zephray/Fobu/hardware/pcb/pcb.kicad_pcb

## KiCad design hardware/pcb/pcb.kicad_pcb (2021-03-08)

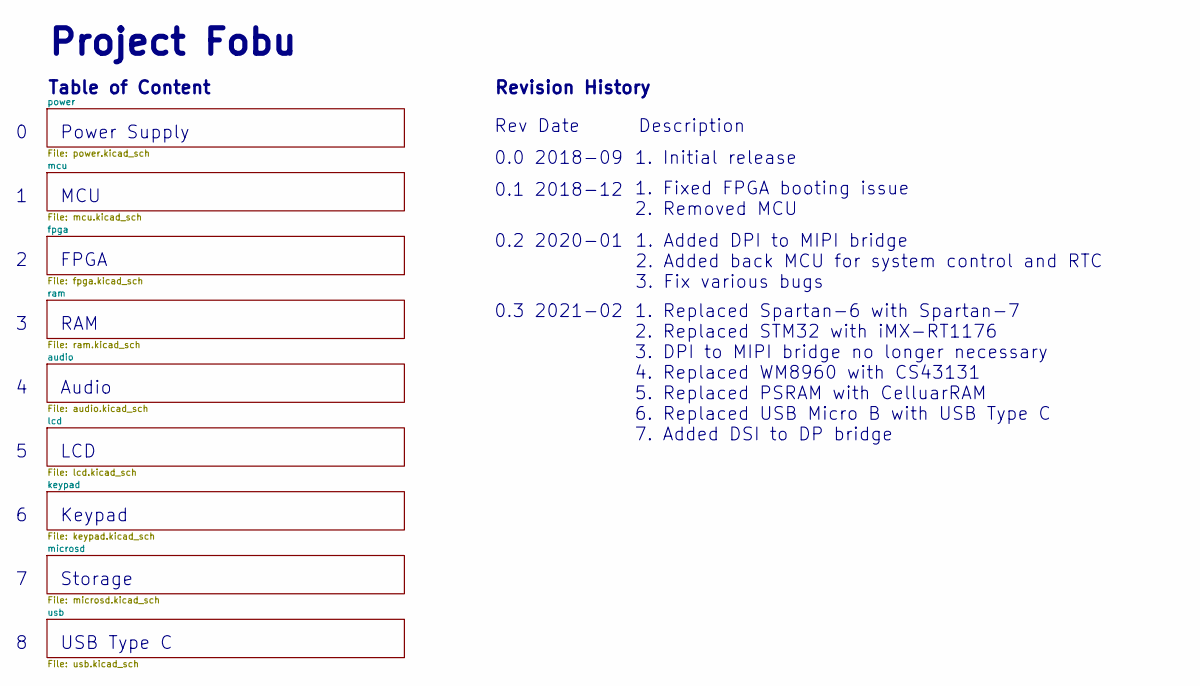
[picture p3: schematic pcb.kicad_sch, Fobu]

Notes on the sheet:
Project Fobu
Table of Content
Power Supply
MCU
FPGA
RAM
Audio
LCD
Keypad
Storage
USB Type C
Revision History
Rev Date Description
0.0 2018-09
0.1 2018-12
0.2 2020-01
0.3 2021-02
1. Initial release
1. Fixed FPGA booting issue 2. Removed MCU
1. Replaced Spartan-6 with Spartan-7 2. Replaced STM32 with iMX-RT1176 3. DPI to MIPI bridge no longer necessary 4. Replaced WM8960 with CS43131 5. Replaced PSRAM with CelluarRAM 6. Replaced USB Micro B with USB Type C 7. Added DSI to DP bridge
1. Added DPI to MIPI bridge 2. Added back MCU for system control and RTC 3. Fix various bugs

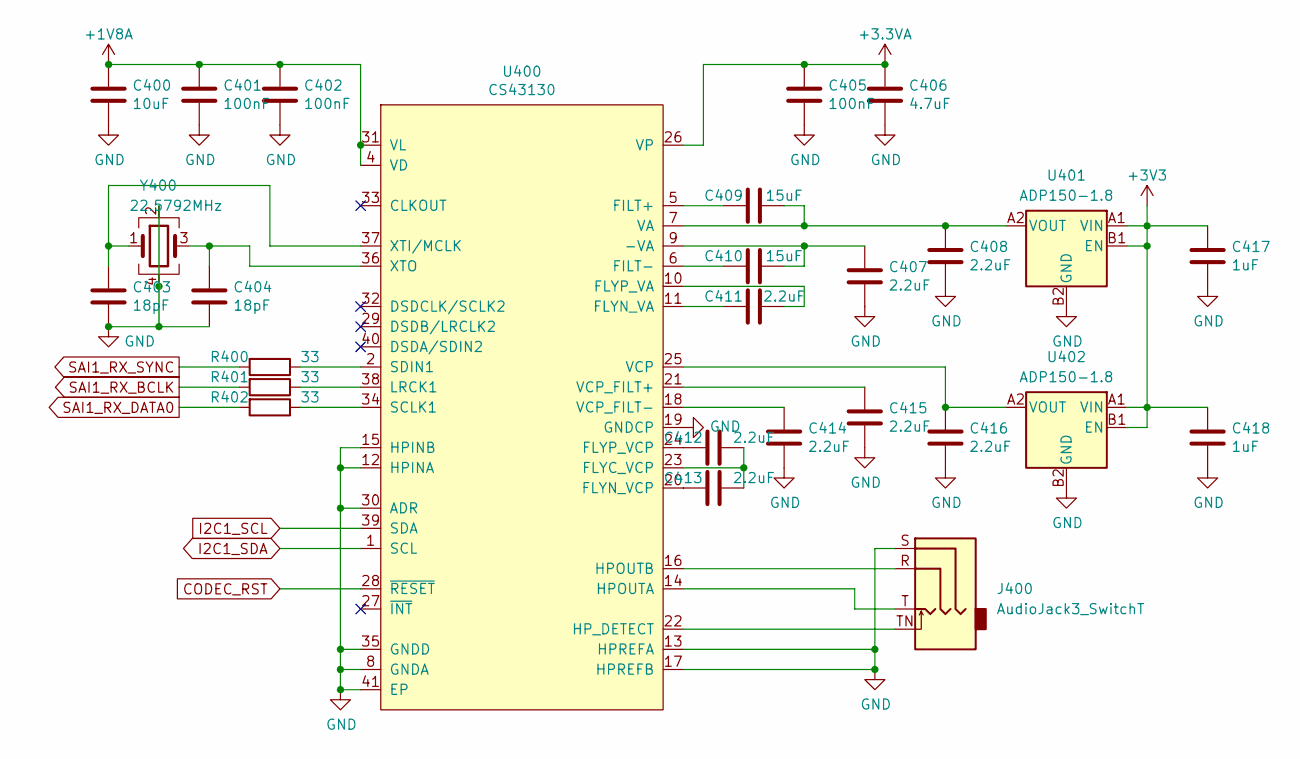
[picture p4: schematic audio.kicad_sch, Fobu]

Parts:
C400: 10uF; C_0402_1005Metric
C401, C402, C405: 100nF; C_0201_0603Metric
C403, C404: 18pF; C_0201_0603Metric
C406: 4.7uF; C_0402_1005Metric
C407, C408, C411, C412, C413, C414, C415, C416: 2.2uF; C_0402_1005Metric
C409, C410: 15uF; C_0603_1608Metric
C417, C418: 1uF; C_0402_1005Metric
J400: AudioJack3_SwitchT; PJ-327E
R400, R401, R402: 33; R_0402_1005Metric
U400: CS43130; QFN-40-1EP_5x5mm_P0.4mm_EP3.6x3.6mm_ThermalVias
U401, U402: ADP150-1.8; CSP-4_2x2_0.8x0.8mm
Y400: 22.5792MHz; Oscillator_SMD_Abracon_ASE-4Pin_3.2x2.5mm

Connections:
+1V8A: C400.1, C401.1, C402.1, U400.4 (VD), U400.31 (VL); also elsewhere on the board
+3.3VA: C405.1, C406.1, U400.26 (VP); also elsewhere on the board
+3V3: C417.1, C418.1, U401.A1 (VIN), U401.B1 (EN), U402.A1 (VIN), U402.B1 (EN); also elsewhere on the board
CODEC_RST: U400.28 (~RESET)
GND: C400.2, C401.2, C402.2, C403.2, C404.2, C405.2, C406.2, C407.2, C408.2, C414.2, C415.2, C416.2, C417.2, C418.2, J400.S, U400.8 (GNDA), U400.12 (HPINA), U400.13 (HPREFA), U400.15 (HPINB), U400.17 (HPREFB), U400.19 (GNDCP), U400.30 (ADR), U400.35 (GNDD), U400.41 (EP), U401.B2 (GND), U402.B2 (GND), Y400.2, Y400.4; also elsewhere on the board
I2C1_SCL: U400.39 (SDA); also elsewhere on the board
I2C1_SDA: U400.1 (SCL); also elsewhere on the board
unnamed: C403.1, U400.37 (XTI/MCLK), Y400.1
unnamed: C404.1, U400.36 (XTO), Y400.3
unnamed: C407.1, C410.1, U400.9 (-VA)
unnamed: C408.1, C409.1, U400.7 (VA), U401.A2 (VOUT)
unnamed: C409.2, U400.5 (FILT+)
unnamed: C410.2, U400.6 (FILT-)
unnamed: C411.1, U400.10 (FLYP_VA)
unnamed: C411.2, U400.11 (FLYN_VA)
unnamed: C412.1, C413.1, U400.23 (FLYC_VCP)
unnamed: C412.2, U400.24 (FLYP_VCP)
unnamed: C413.2, U400.20 (FLYN_VCP)
unnamed: C414.1, U400.18 (VCP_FILT-)
unnamed: C415.1, U400.21 (VCP_FILT+)
unnamed: C416.1, U400.25 (VCP), U402.A2 (VOUT)
unnamed: J400.R, U400.16 (HPOUTB)
unnamed: J400.T, U400.14 (HPOUTA)
unnamed: J400.TN, U400.22 (HP_DETECT)
unnamed: R400.1, U400.2 (SDIN1)
unnamed: R401.1, U400.38 (LRCK1)
unnamed: R402.1, U400.34 (SCLK1)
SAI1_RX_BCLK: R401.2; also elsewhere on the board
SAI1_RX_DATA0: R402.2; also elsewhere on the board
SAI1_RX_SYNC: R400.2; also elsewhere on the board

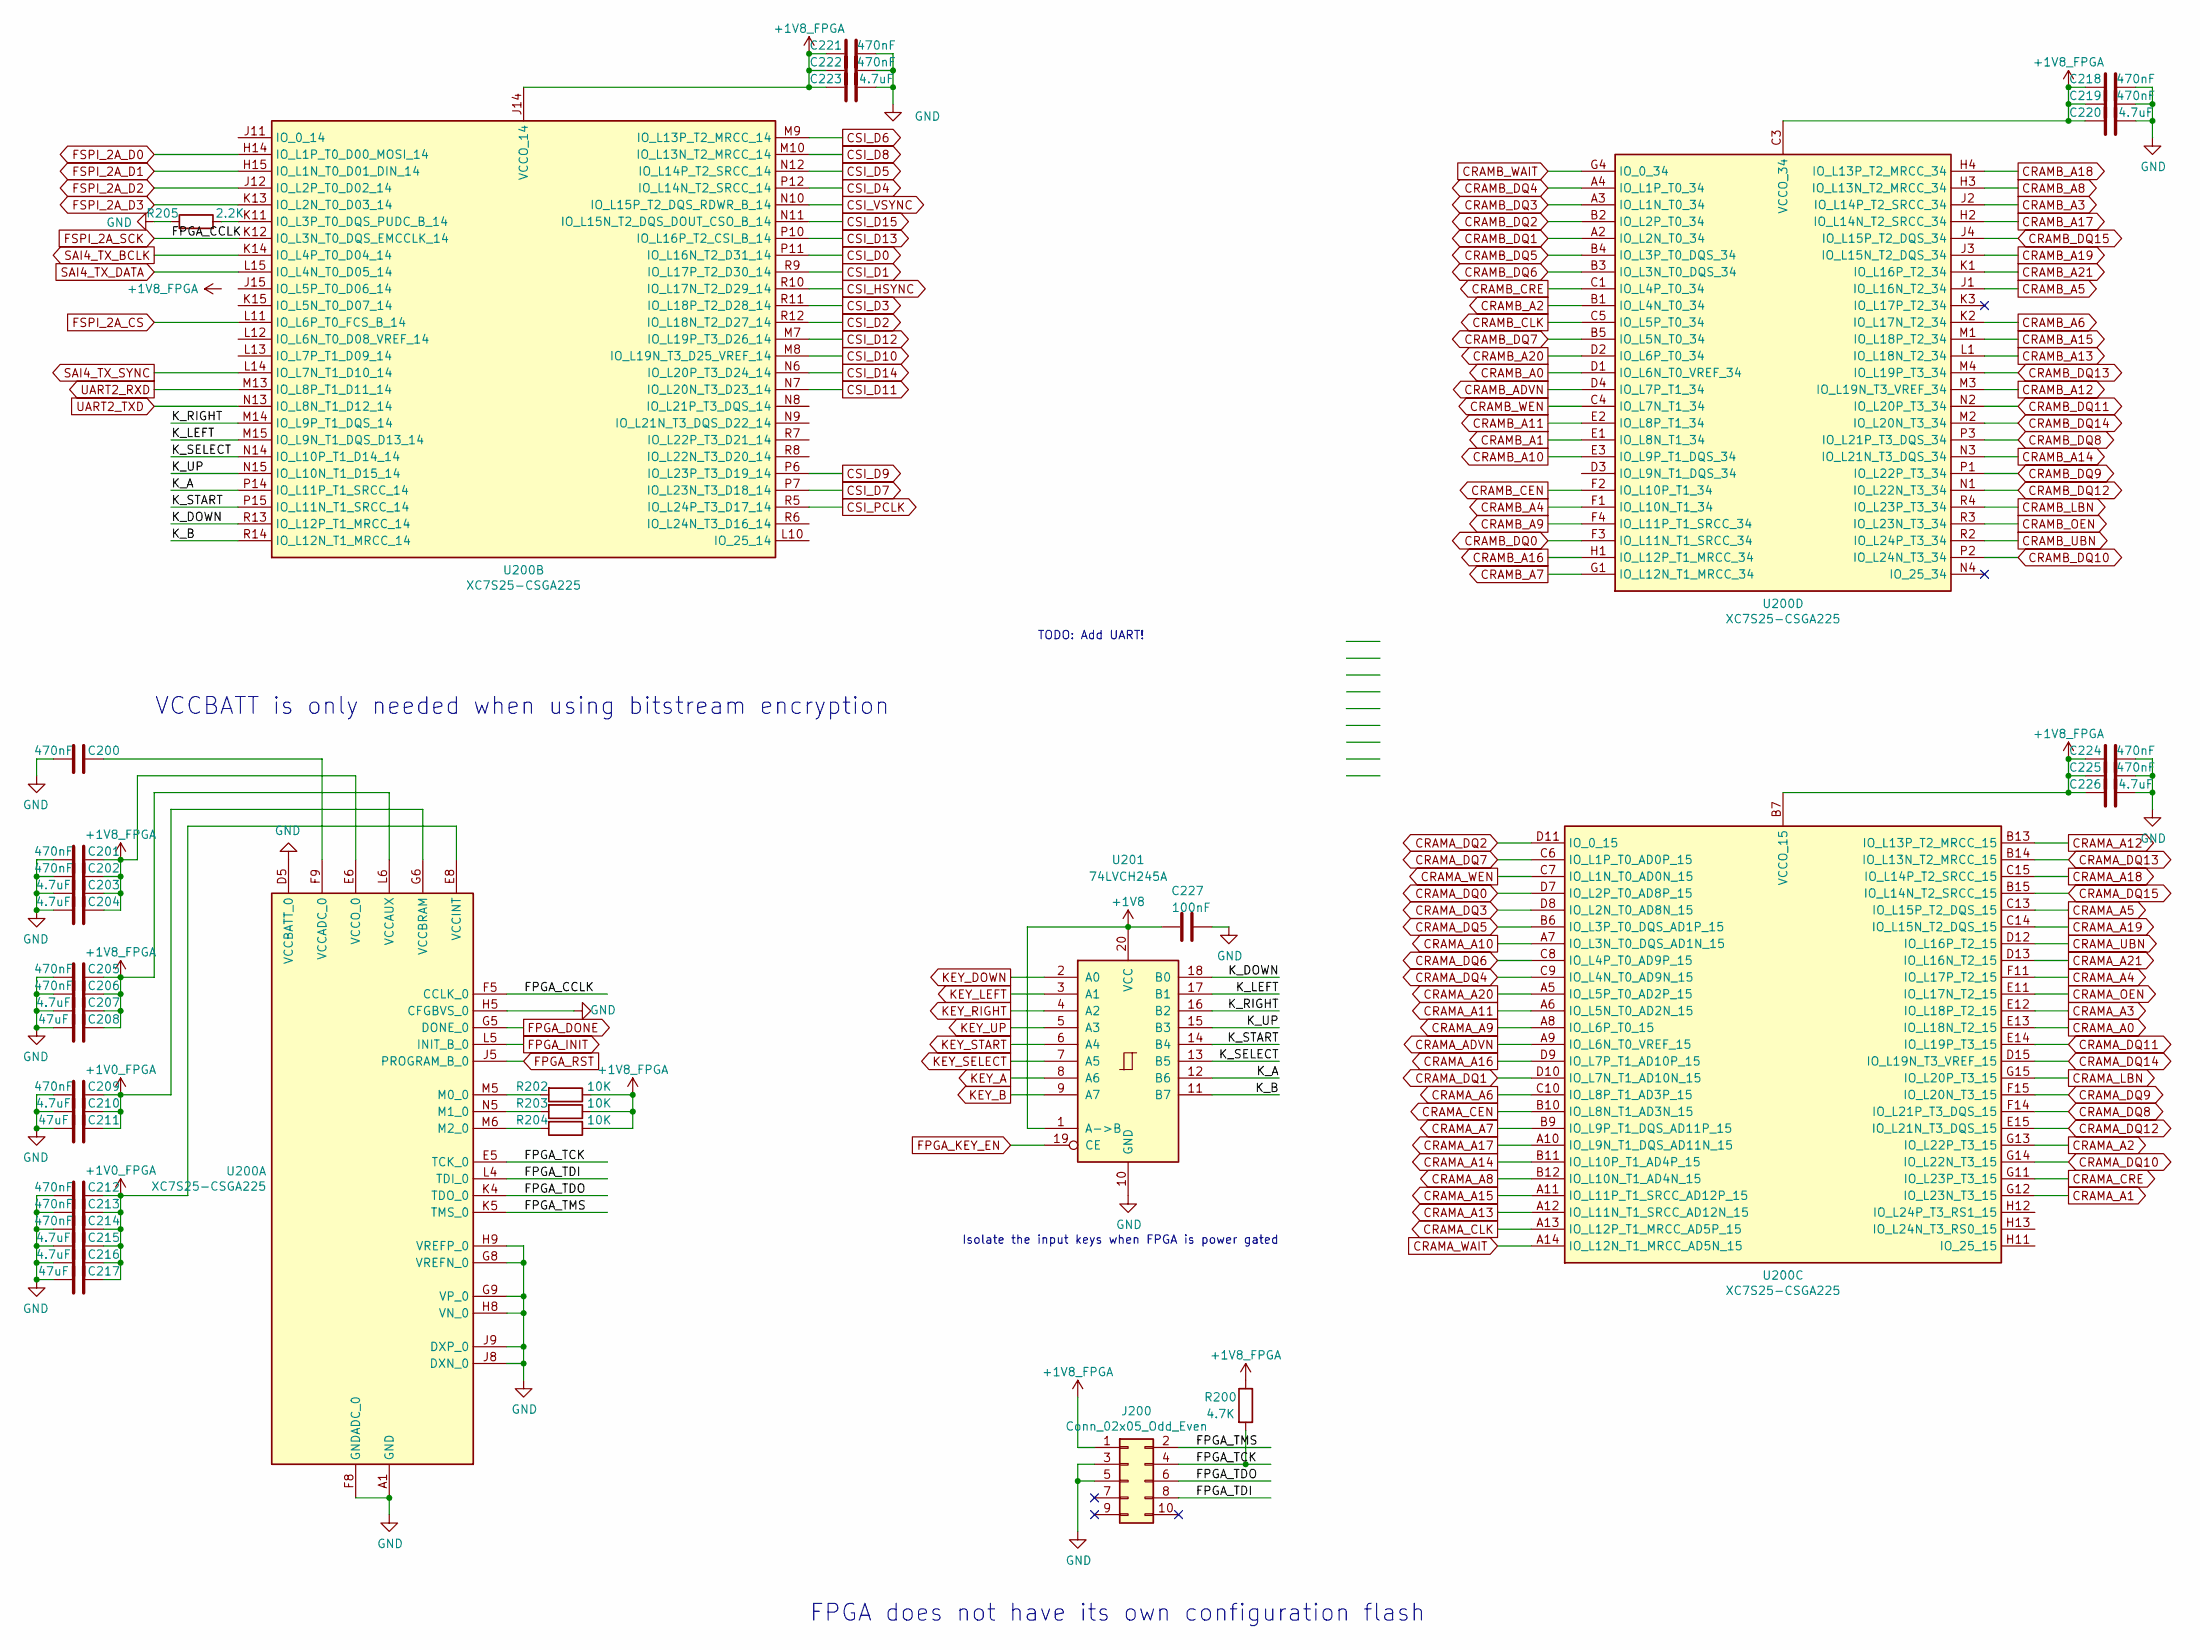
[picture p5: schematic fpga.kicad_sch, Fobu]

Parts:
C200, C201, C202, C205, C206, C209, C212, C213, C214, C218, C219, C221, C222, C224, C225: 470nF; C_0201_0603Metric
C203, C204, C207, C210, C215, C216, C220, C223, C226: 4.7uF; C_0402_1005Metric
C208, C211, C217: 47uF; C_0603_1608Metric
C227: 100nF; C_0201_0603Metric
J200: Conn_02x05_Odd_Even; PinHeader_2x05_P1.27mm_Vertical_SMD
R200: 4.7K; R_0402_1005Metric
R202, R203, R204: 10K; R_0402_1005Metric
R205: 2.2K; R_0402_1005Metric
U200: XC7S25-CSGA225; Xilinx_CSGA225
U201: 74LVCH245A; DHVQFN-20_EP_4.5x2.5_Pitch0.5mm

Connections:
+1V0_FPGA: C209.2, C210.2, C211.2, C212.2, C213.2, C214.2, C215.2, C216.2, C217.2, U200.E8 (VCCINT), U200.E10 (VCCINT), U200.F7 (VCCINT), U200.G6 (VCCBRAM), U200.G10 (VCCINT), U200.H7 (VCCINT), U200.J6 (VCCBRAM), U200.J10 (VCCINT), U200.K7 (VCCINT), U200.K9 (VCCINT); also elsewhere on the board
+1V8: C227.1, U201.1 (A->B), U201.20 (VCC); also elsewhere on the board
/fpga/FPGA_TCK: J200.4, R200.2, U200.E5 (TCK_0)
/fpga/FPGA_TDI: J200.8, U200.L4 (TDI_0)
/fpga/FPGA_TDO: J200.6, U200.K4 (TDO_0)
/fpga/FPGA_TMS: J200.2, U200.K5 (TMS_0)
/fpga/K_A: U200.P14 (IO_L11P_T1_SRCC_14), U201.12 (B6)
/fpga/K_B: U200.R14 (IO_L12N_T1_MRCC_14), U201.11 (B7)
/fpga/K_DOWN: U200.R13 (IO_L12P_T1_MRCC_14), U201.18 (B0)
/fpga/K_LEFT: U200.M15 (IO_L9N_T1_DQS_D13_14), U201.17 (B1)
/fpga/K_RIGHT: U200.M14 (IO_L9P_T1_DQS_14), U201.16 (B2)
/fpga/K_SELECT: U200.N14 (IO_L10P_T1_D14_14), U201.13 (B5)
/fpga/K_START: U200.P15 (IO_L11N_T1_SRCC_14), U201.14 (B4)
/fpga/K_UP: U200.N15 (IO_L10N_T1_D15_14), U201.15 (B3)
CRAMA_A0: U200.E13 (IO_L18N_T2_15); also elsewhere on the board
CRAMA_A1: U200.G12 (IO_L23N_T3_15); also elsewhere on the board
CRAMA_A2: U200.G13 (IO_L22P_T3_15); also elsewhere on the board
CRAMA_A3: U200.E12 (IO_L18P_T2_15); also elsewhere on the board
CRAMA_A4: U200.F11 (IO_L17P_T2_15); also elsewhere on the board
CRAMA_A5: U200.C13 (IO_L15P_T2_DQS_15); also elsewhere on the board
CRAMA_A6: U200.C10 (IO_L8P_T1_AD3P_15); also elsewhere on the board
CRAMA_A7: U200.B9 (IO_L9P_T1_DQS_AD11P_15); also elsewhere on the board
CRAMA_A8: U200.B12 (IO_L10N_T1_AD4N_15); also elsewhere on the board
CRAMA_A9: U200.A8 (IO_L6P_T0_15); also elsewhere on the board
CRAMA_A10: U200.A7 (IO_L3N_T0_DQS_AD1N_15); also elsewhere on the board
CRAMA_A11: U200.A6 (IO_L5N_T0_AD2N_15); also elsewhere on the board
CRAMA_A12: U200.B13 (IO_L13P_T2_MRCC_15); also elsewhere on the board
CRAMA_A13: U200.A12 (IO_L11N_T1_SRCC_AD12N_15); also elsewhere on the board
CRAMA_A14: U200.B11 (IO_L10P_T1_AD4P_15); also elsewhere on the board
CRAMA_A15: U200.A11 (IO_L11P_T1_SRCC_AD12P_15); also elsewhere on the board
CRAMA_A16: U200.D9 (IO_L7P_T1_AD10P_15); also elsewhere on the board
CRAMA_A17: U200.A10 (IO_L9N_T1_DQS_AD11N_15); also elsewhere on the board
CRAMA_A18: U200.C15 (IO_L14P_T2_SRCC_15); also elsewhere on the board
CRAMA_A19: U200.C14 (IO_L15N_T2_DQS_15); also elsewhere on the board
CRAMA_A20: U200.A5 (IO_L5P_T0_AD2P_15); also elsewhere on the board
CRAMA_A21: U200.D13 (IO_L16N_T2_15); also elsewhere on the board
CRAMA_ADVN: U200.A9 (IO_L6N_T0_VREF_15); also elsewhere on the board
CRAMA_CEN: U200.B10 (IO_L8N_T1_AD3N_15); also elsewhere on the board
CRAMA_CLK: U200.A13 (IO_L12P_T1_MRCC_AD5P_15); also elsewhere on the board
CRAMA_CRE: U200.G11 (IO_L23P_T3_15); also elsewhere on the board
CRAMA_DQ0: U200.D7 (IO_L2P_T0_AD8P_15); also elsewhere on the board
CRAMA_DQ1: U200.D10 (IO_L7N_T1_AD10N_15); also elsewhere on the board
CRAMA_DQ2: U200.D11 (IO_0_15); also elsewhere on the board
CRAMA_DQ3: U200.D8 (IO_L2N_T0_AD8N_15); also elsewhere on the board
CRAMA_DQ4: U200.C9 (IO_L4N_T0_AD9N_15); also elsewhere on the board
CRAMA_DQ5: U200.B6 (IO_L3P_T0_DQS_AD1P_15); also elsewhere on the board
CRAMA_DQ6: U200.C8 (IO_L4P_T0_AD9P_15); also elsewhere on the board
CRAMA_DQ7: U200.C6 (IO_L1P_T0_AD0P_15); also elsewhere on the board
CRAMA_DQ8: U200.F14 (IO_L21P_T3_DQS_15); also elsewhere on the board
CRAMA_DQ9: U200.F15 (IO_L20N_T3_15); also elsewhere on the board
CRAMA_DQ10: U200.G14 (IO_L22N_T3_15); also elsewhere on the board
CRAMA_DQ11: U200.E14 (IO_L19P_T3_15); also elsewhere on the board
CRAMA_DQ12: U200.E15 (IO_L21N_T3_DQS_15); also elsewhere on the board
CRAMA_DQ13: U200.B14 (IO_L13N_T2_MRCC_15); also elsewhere on the board
CRAMA_DQ14: U200.D15 (IO_L19N_T3_VREF_15); also elsewhere on the board
CRAMA_DQ15: U200.B15 (IO_L14N_T2_SRCC_15); also elsewhere on the board
CRAMA_LBN: U200.G15 (IO_L20P_T3_15); also elsewhere on the board
CRAMA_OEN: U200.E11 (IO_L17N_T2_15); also elsewhere on the board
CRAMA_UBN: U200.D12 (IO_L16P_T2_15); also elsewhere on the board
CRAMA_WAIT: U200.A14 (IO_L12N_T1_MRCC_AD5N_15); also elsewhere on the board
CRAMA_WEN: U200.C7 (IO_L1N_T0_AD0N_15); also elsewhere on the board
CRAMB_A0: U200.D1 (IO_L6N_T0_VREF_34); also elsewhere on the board
CRAMB_A1: U200.E1 (IO_L8N_T1_34); also elsewhere on the board
CRAMB_A2: U200.B1 (IO_L4N_T0_34); also elsewhere on the board
CRAMB_A3: U200.J2 (IO_L14P_T2_SRCC_34); also elsewhere on the board
CRAMB_A4: U200.F1 (IO_L10N_T1_34); also elsewhere on the board
CRAMB_A5: U200.J1 (IO_L16N_T2_34); also elsewhere on the board
CRAMB_A6: U200.K2 (IO_L17N_T2_34); also elsewhere on the board
CRAMB_A7: U200.G1 (IO_L12N_T1_MRCC_34); also elsewhere on the board
CRAMB_A8: U200.H3 (IO_L13N_T2_MRCC_34); also elsewhere on the board
CRAMB_A9: U200.F4 (IO_L11P_T1_SRCC_34); also elsewhere on the board
CRAMB_A10: U200.E3 (IO_L9P_T1_DQS_34); also elsewhere on the board
CRAMB_A11: U200.E2 (IO_L8P_T1_34); also elsewhere on the board
CRAMB_A12: U200.M3 (IO_L19N_T3_VREF_34); also elsewhere on the board
CRAMB_A13: U200.L1 (IO_L18N_T2_34); also elsewhere on the board
CRAMB_A14: U200.N3 (IO_L21N_T3_DQS_34); also elsewhere on the board
CRAMB_A15: U200.M1 (IO_L18P_T2_34); also elsewhere on the board
CRAMB_A16: U200.H1 (IO_L12P_T1_MRCC_34); also elsewhere on the board
CRAMB_A17: U200.H2 (IO_L14N_T2_SRCC_34); also elsewhere on the board
CRAMB_A18: U200.H4 (IO_L13P_T2_MRCC_34); also elsewhere on the board
CRAMB_A19: U200.J3 (IO_L15N_T2_DQS_34); also elsewhere on the board
CRAMB_A20: U200.D2 (IO_L6P_T0_34); also elsewhere on the board
CRAMB_A21: U200.K1 (IO_L16P_T2_34); also elsewhere on the board
CRAMB_ADVN: U200.D4 (IO_L7P_T1_34); also elsewhere on the board
CRAMB_CEN: U200.F2 (IO_L10P_T1_34); also elsewhere on the board
CRAMB_CLK: U200.C5 (IO_L5P_T0_34); also elsewhere on the board
CRAMB_CRE: U200.C1 (IO_L4P_T0_34); also elsewhere on the board
CRAMB_DQ0: U200.F3 (IO_L11N_T1_SRCC_34); also elsewhere on the board
CRAMB_DQ1: U200.A2 (IO_L2N_T0_34); also elsewhere on the board
CRAMB_DQ2: U200.B2 (IO_L2P_T0_34); also elsewhere on the board
CRAMB_DQ3: U200.A3 (IO_L1N_T0_34); also elsewhere on the board
CRAMB_DQ4: U200.A4 (IO_L1P_T0_34); also elsewhere on the board
CRAMB_DQ5: U200.B4 (IO_L3P_T0_DQS_34); also elsewhere on the board
CRAMB_DQ6: U200.B3 (IO_L3N_T0_DQS_34); also elsewhere on the board
CRAMB_DQ7: U200.B5 (IO_L5N_T0_34); also elsewhere on the board
CRAMB_DQ8: U200.P3 (IO_L21P_T3_DQS_34); also elsewhere on the board
CRAMB_DQ9: U200.P1 (IO_L22P_T3_34); also elsewhere on the board
CRAMB_DQ10: U200.P2 (IO_L24N_T3_34); also elsewhere on the board
CRAMB_DQ11: U200.N2 (IO_L20P_T3_34); also elsewhere on the board
CRAMB_DQ12: U200.N1 (IO_L22N_T3_34); also elsewhere on the board
CRAMB_DQ13: U200.M4 (IO_L19P_T3_34); also elsewhere on the board
CRAMB_DQ14: U200.M2 (IO_L20N_T3_34); also elsewhere on the board
CRAMB_DQ15: U200.J4 (IO_L15P_T2_DQS_34); also elsewhere on the board
CRAMB_LBN: U200.R4 (IO_L23P_T3_34); also elsewhere on the board
CRAMB_OEN: U200.R3 (IO_L23N_T3_34); also elsewhere on the board
CRAMB_UBN: U200.R2 (IO_L24P_T3_34); also elsewhere on the board
CRAMB_WAIT: U200.G4 (IO_0_34); also elsewhere on the board
CRAMB_WEN: U200.C4 (IO_L7N_T1_34); also elsewhere on the board
CSI_D0: U200.P11 (IO_L16N_T2_D31_14); also elsewhere on the board
CSI_D1: U200.R9 (IO_L17P_T2_D30_14); also elsewhere on the board
CSI_D2: U200.R12 (IO_L18N_T2_D27_14); also elsewhere on the board
CSI_D3: U200.R11 (IO_L18P_T2_D28_14); also elsewhere on the board
CSI_D4: U200.P12 (IO_L14N_T2_SRCC_14); also elsewhere on the board
CSI_D5: U200.N12 (IO_L14P_T2_SRCC_14); also elsewhere on the board
CSI_D6: U200.M9 (IO_L13P_T2_MRCC_14); also elsewhere on the board
CSI_D7: U200.P7 (IO_L23N_T3_D18_14); also elsewhere on the board
CSI_D8: U200.M10 (IO_L13N_T2_MRCC_14); also elsewhere on the board
CSI_D9: U200.P6 (IO_L23P_T3_D19_14); also elsewhere on the board
CSI_D10: U200.M8 (IO_L19N_T3_D25_VREF_14); also elsewhere on the board
CSI_D11: U200.N7 (IO_L20N_T3_D23_14); also elsewhere on the board
CSI_D12: U200.M7 (IO_L19P_T3_D26_14); also elsewhere on the board
CSI_D13: U200.P10 (IO_L16P_T2_CSI_B_14); also elsewhere on the board
CSI_D14: U200.N6 (IO_L20P_T3_D24_14); also elsewhere on the board
CSI_D15: U200.N11 (IO_L15N_T2_DQS_DOUT_CSO_B_14); also elsewhere on the board
CSI_HSYNC: U200.R10 (IO_L17N_T2_D29_14); also elsewhere on the board
CSI_PCLK: U200.R5 (IO_L24P_T3_D17_14); also elsewhere on the board
CSI_VSYNC: U200.N10 (IO_L15P_T2_DQS_RDWR_B_14); also elsewhere on the board
FPGA_DONE: U200.G5 (DONE_0); also elsewhere on the board
FPGA_INIT: U200.L5 (INIT_B_0); also elsewhere on the board
FPGA_KEY_EN: U201.19 (CE); also elsewhere on the board
FPGA_RST: U200.J5 (PROGRAM_B_0); also elsewhere on the board
FSPI_2A_CS: U200.L11 (IO_L6P_T0_FCS_B_14); also elsewhere on the board
FSPI_2A_D0: U200.H14 (IO_L1P_T0_D00_MOSI_14); also elsewhere on the board
FSPI_2A_D1: U200.H15 (IO_L1N_T0_D01_DIN_14); also elsewhere on the board
FSPI_2A_D2: U200.J12 (IO_L2P_T0_D02_14); also elsewhere on the board
FSPI_2A_D3: U200.K13 (IO_L2N_T0_D03_14); also elsewhere on the board
FSPI_2A_SCK: U200.F5 (CCLK_0), U200.K12 (IO_L3N_T0_DQS_EMCCLK_14); also elsewhere on the board
GND: C200.1, C201.1, C202.1, C203.1, C204.1, C205.1, C206.1, C207.1, C208.1, C209.1, C210.1, C211.1, C212.1, C213.1, C214.1, C215.1, C216.1, C217.1, C218.1, C219.1, C220.1, C221.1, C222.1, C223.1, C224.1, C225.1, C226.1, C227.2, J200.3, J200.5, R205.1, U200.A1 (GND), U200.A15 (GND), U200.B8 (GND), U200.C2 (GND), U200.C12 (GND), U200.D5 (VCCBATT_0), U200.D6 (GND), U200.D14 (GND), U200.E4 (GND), U200.E7 (GND), U200.E9 (GND), U200.F6 (GND), U200.F8 (GNDADC_0), U200.F10 (GND), U200.F13 (GND), U200.G3 (GND), U200.G7 (GND), U200.G8 (VREFN_0), U200.G9 (VP_0), U200.H5 (CFGBVS_0), U200.H6 (GND), U200.H8 (VN_0), U200.H9 (VREFP_0), U200.H10 (GND), U200.J7 (GND), U200.J8 (DXN_0), U200.J9 (DXP_0), U200.J13 (GND), U200.K6 (GND), U200.K8 (GND), U200.K10 (GND), U200.L2 (GND), U200.L7 (GND), U200.L9 (GND), U200.M11 (GND), U200.P4 (GND), U200.P8 (GND), U200.P13 (GND), U200.R1 (GND), U200.R15 (GND), U201.10 (GND); also elsewhere on the board
KEY_A: U201.8 (A6); also elsewhere on the board
KEY_B: U201.9 (A7); also elsewhere on the board
KEY_DOWN: U201.2 (A0); also elsewhere on the board
KEY_LEFT: U201.3 (A1); also elsewhere on the board
KEY_RIGHT: U201.4 (A2); also elsewhere on the board
KEY_SELECT: U201.7 (A5); also elsewhere on the board
KEY_START: U201.6 (A4); also elsewhere on the board
KEY_UP: U201.5 (A3); also elsewhere on the board
unnamed: R202.2, U200.M5 (M0_0)
unnamed: R203.2, U200.N5 (M1_0)
unnamed: R204.2, U200.M6 (M2_0)
unnamed: R205.2, U200.K11 (IO_L3P_T0_DQS_PUDC_B_14)
SAI4_TX_BCLK: U200.K14 (IO_L4P_T0_D04_14); also elsewhere on the board
SAI4_TX_DATA: U200.L15 (IO_L4N_T0_D05_14); also elsewhere on the board
SAI4_TX_SYNC: U200.L14 (IO_L7N_T1_D10_14); also elsewhere on the board
UART2_RXD: U200.M13 (IO_L8P_T1_D11_14); also elsewhere on the board
UART2_TXD: U200.N13 (IO_L8N_T1_D12_14); also elsewhere on the board

Notes on the sheet:
VCCBATT is only needed when using bitstream encryption
FPGA does not have its own configuration flash
TODO: Add UART!
Isolate the input keys when FPGA is power gated

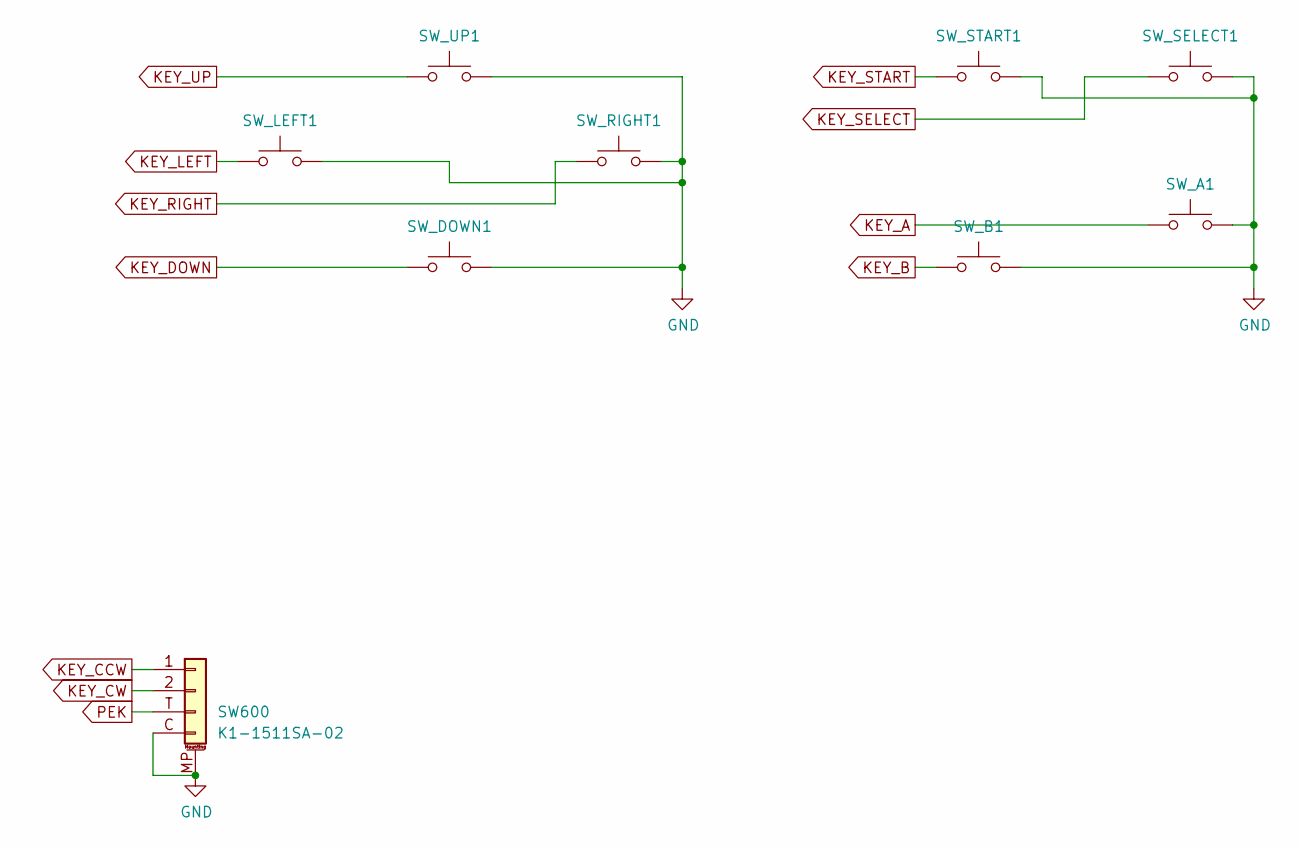
[picture p6: schematic keypad.kicad_sch, Fobu]

Parts:
SW600: K1-1511SA-02
SW_A1: SW_Push; SW_SPST_K21177SR
SW_B1: SW_Push; SW_SPST_K21177SR
SW_DOWN1: SW_Push; SW_SPST_K21177SR
SW_LEFT1: SW_Push; SW_SPST_K21177SR
SW_RIGHT1: SW_Push; SW_SPST_K21177SR
SW_SELECT1: SW_Push; SW_SPST_K21177SR
SW_START1: SW_Push; SW_SPST_K21177SR
SW_UP1: SW_Push; SW_SPST_K21177SR

Connections:
GND: SW600.C (Pin_4), SW600.MP (MountPin), SW_A1.2, SW_B1.2, SW_DOWN1.2, SW_LEFT1.2, SW_RIGHT1.2, SW_SELECT1.2, SW_START1.2, SW_UP1.2; also elsewhere on the board
KEY_A: SW_A1.1; also elsewhere on the board
KEY_B: SW_B1.1; also elsewhere on the board
KEY_CCW: SW600.1
KEY_CW: SW600.2
KEY_DOWN: SW_DOWN1.1; also elsewhere on the board
KEY_LEFT: SW_LEFT1.1; also elsewhere on the board
KEY_RIGHT: SW_RIGHT1.1; also elsewhere on the board
KEY_SELECT: SW_SELECT1.1; also elsewhere on the board
KEY_START: SW_START1.1; also elsewhere on the board
KEY_UP: SW_UP1.1; also elsewhere on the board
PEK: SW600.T (Pin_3); also elsewhere on the board

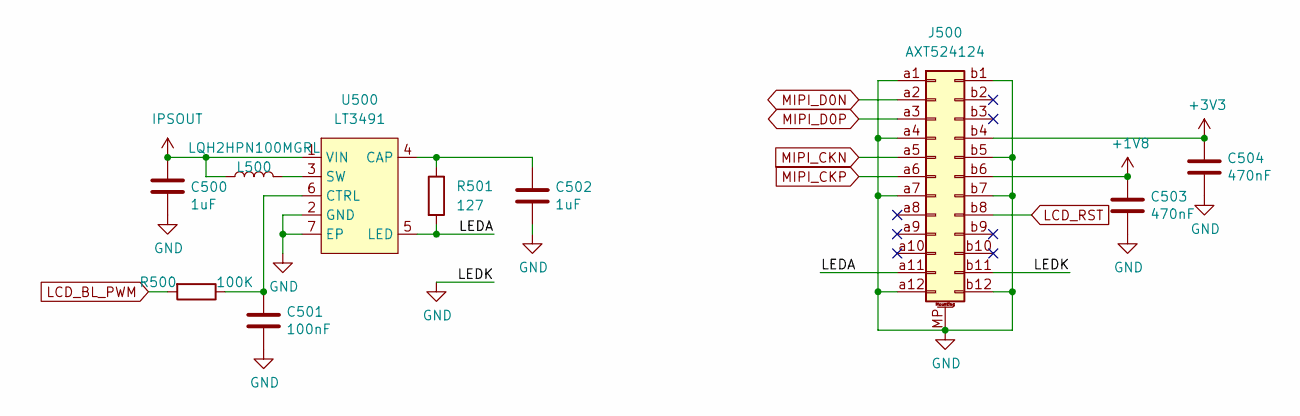
[picture p7: schematic lcd.kicad_sch, Fobu]

Parts:
C500, C502: 1uF; C_0402_1005Metric
C501: 100nF; C_0201_0603Metric
C503, C504: 470nF; C_0201_0603Metric
J500: AXT524124
L500: LQH2HPN100MGRL; L_1008_2520Metric
R500: 100K; R_0402_1005Metric
R501: 127; R_0402_1005Metric
U500: LT3491; DFN-6-1EP_2x2mm_P0.5mm_EP0.61x1.42mm

Connections:
+1V8: C503.1, J500.b6; also elsewhere on the board
+3V3: C504.1, J500.b4; also elsewhere on the board
/lcd/LEDA: J500.a11, R501.2, U500.5 (LED)
GND: C500.2, C501.2, C502.2, C503.2, C504.2, J500.MP (MountPin), J500.a1, J500.a4, J500.a7, J500.a12, J500.b1, J500.b5, J500.b7, J500.b11, J500.b12, U500.2 (GND), U500.7 (EP); also elsewhere on the board
IPSOUT: C500.1, L500.1, U500.1 (VIN); also elsewhere on the board
LCD_BL_PWM: R500.2
LCD_RST: J500.b8
MIPI_CKN: J500.a5; also elsewhere on the board
MIPI_CKP: J500.a6; also elsewhere on the board
MIPI_D0N: J500.a2; also elsewhere on the board
MIPI_D0P: J500.a3; also elsewhere on the board
unnamed: C501.1, R500.1, U500.6 (CTRL)
unnamed: C502.1, R501.1, U500.4 (CAP)
unnamed: L500.2, U500.3 (SW)
