zephray/Fobu/hardware/pcb/pcb.kicad_pcb

## KiCad design hardware/pcb/pcb.kicad_pcb (continued)

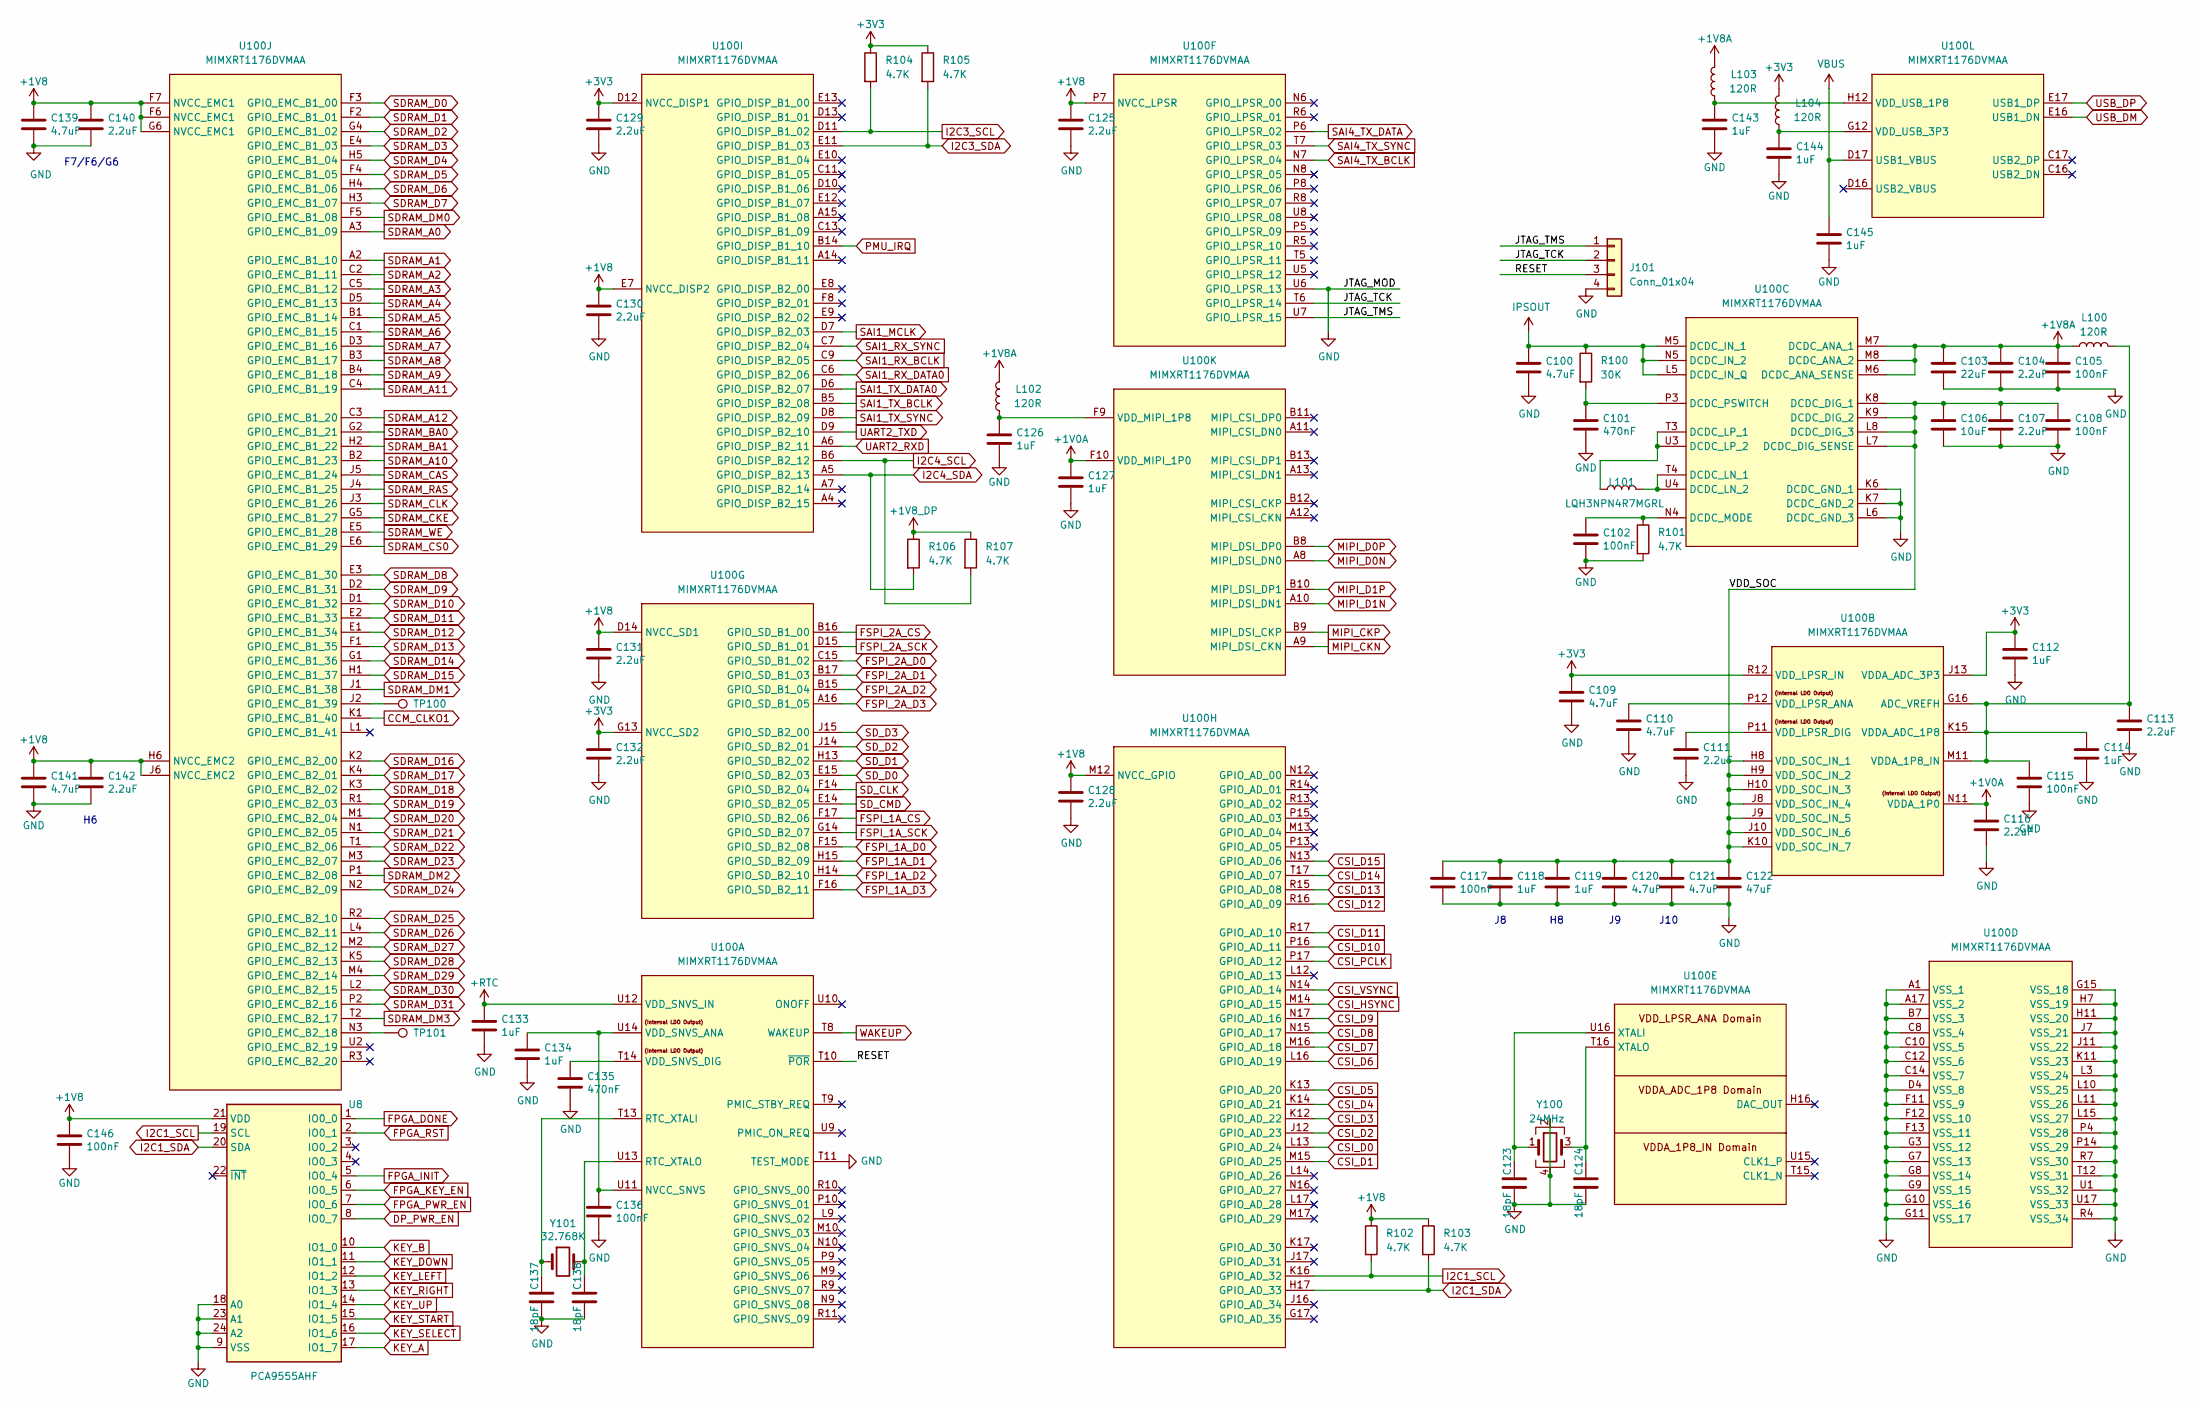
[picture p8: schematic mcu.kicad_sch, Fobu]

Parts:
C100, C109, C110, C120, C121, C139, C141: 4.7uF; C_0402_1005Metric
C101, C135: 470nF; C_0201_0603Metric
C102, C105, C108, C115, C117, C136, C146: 100nF; C_0201_0603Metric
C103: 22uF; C_0603_1608Metric
C104, C107, C111, C113, C116, C125, C128, C129, C130, C131, C132, C140, C142: 2.2uF; C_0402_1005Metric
C106: 10uF; C_0402_1005Metric
C112, C114, C118, C119, C126, C127, C133, C134, C143, C144, C145: 1uF; C_0402_1005Metric
C122: 47uF; C_0603_1608Metric
C123, C124, C137, C138: 18pF; C_0201_0603Metric
J101: Conn_01x04; PinHeader_1x04_P1.27mm_Vertical_SMD_Pin1Left
L100, L102, L103, L104: 120R; L_0402_1005Metric
L101: LQH3NPN4R7MGRL; L_Vishay_IHLP-1212
R100: 30K; R_0402_1005Metric
R101, R102, R103, R104, R105, R106, R107: 4.7K; R_0402_1005Metric
TP100, TP101: TestPoint; TestPoint_Pad_D0.5mm
U8: PCA9555AHF; HVQFN-24-1EP_4x4mm_P0.5mm_EP2.5x2.5mm
U100: MIMXRT1176DVMAA; BGA-289_17x17_14.0x14.0mm
Y100: 24MHz; Oscillator_SMD_Abracon_ASE-4Pin_3.2x2.5mm
Y101: 32.768K; Crystal_SMD_TXC_9HT11-2Pin_2.0x1.2mm_HandSoldering

Connections:
+1V0A: C116.1, C127.1, U100.F10 (VDD_MIPI_1P0), U100.N11 (VDDA_1P0)
+1V8: C125.1, C128.1, C130.1, C131.1, C139.1, C140.1, C141.1, C142.1, C146.1, R102.1, R103.1, U8.21 (VDD), U100.D14 (NVCC_SD1), U100.E7 (NVCC_DISP2), U100.F6 (NVCC_EMC1), U100.F7 (NVCC_EMC1), U100.G6 (NVCC_EMC1), U100.H6 (NVCC_EMC2), U100.J6 (NVCC_EMC2), U100.M12 (NVCC_GPIO), U100.P7 (NVCC_LPSR); also elsewhere on the board
+1V8A: C103.1, C104.1, C105.1, L100.1, L102.2, L103.2, U100.M6 (DCDC_ANA_SENSE), U100.M7 (DCDC_ANA_1), U100.M8 (DCDC_ANA_2); also elsewhere on the board
+1V8_DP: R106.1, R107.1; also elsewhere on the board
+3V3: C109.1, C112.1, C129.1, C132.1, L104.2, R104.1, R105.1, U100.D12 (NVCC_DISP1), U100.G13 (NVCC_SD2), U100.J13 (VDDA_ADC_3P3), U100.R12 (VDD_LPSR_IN); also elsewhere on the board
+RTC: C133.1, U100.U12 (VDD_SNVS_IN); also elsewhere on the board
/mcu/JTAG_TCK: J101.2, U100.T6 (GPIO_LPSR_14)
/mcu/JTAG_TMS: J101.1, U100.U7 (GPIO_LPSR_15)
/mcu/RESET: J101.3, U100.T10 (~POR)
/mcu/VDD_SOC: C106.1, C107.1, C108.1, C117.1, C118.1, C119.1, C120.1, C121.1, C122.1, U100.H8 (VDD_SOC_IN_1), U100.H9 (VDD_SOC_IN_2), U100.H10 (VDD_SOC_IN_3), U100.J8 (VDD_SOC_IN_4), U100.J9 (VDD_SOC_IN_5), U100.J10 (VDD_SOC_IN_6), U100.K8 (DCDC_DIG_1), U100.K9 (DCDC_DIG_2), U100.K10 (VDD_SOC_IN_7), U100.L7 (DCDC_DIG_SENSE), U100.L8 (DCDC_DIG_3)
CCM_CLKO1: U100.K1 (GPIO_EMC_B1_40)
CSI_D0: U100.L13 (GPIO_AD_24); also elsewhere on the board
CSI_D1: U100.M15 (GPIO_AD_25); also elsewhere on the board
CSI_D2: U100.J12 (GPIO_AD_23); also elsewhere on the board
CSI_D3: U100.K12 (GPIO_AD_22); also elsewhere on the board
CSI_D4: U100.K14 (GPIO_AD_21); also elsewhere on the board
CSI_D5: U100.K13 (GPIO_AD_20); also elsewhere on the board
CSI_D6: U100.L16 (GPIO_AD_19); also elsewhere on the board
CSI_D7: U100.M16 (GPIO_AD_18); also elsewhere on the board
CSI_D8: U100.N15 (GPIO_AD_17); also elsewhere on the board
CSI_D9: U100.N17 (GPIO_AD_16); also elsewhere on the board
CSI_D10: U100.P16 (GPIO_AD_11); also elsewhere on the board
CSI_D11: U100.R17 (GPIO_AD_10); also elsewhere on the board
CSI_D12: U100.R16 (GPIO_AD_09); also elsewhere on the board
CSI_D13: U100.R15 (GPIO_AD_08); also elsewhere on the board
CSI_D14: U100.T17 (GPIO_AD_07); also elsewhere on the board
CSI_D15: U100.N13 (GPIO_AD_06); also elsewhere on the board
CSI_HSYNC: U100.M14 (GPIO_AD_15); also elsewhere on the board
CSI_PCLK: U100.P17 (GPIO_AD_12); also elsewhere on the board
CSI_VSYNC: U100.N14 (GPIO_AD_14); also elsewhere on the board
DP_PWR_EN: U8.8 (IO0_7); also elsewhere on the board
FPGA_DONE: U8.1 (IO0_0); also elsewhere on the board
FPGA_INIT: U8.5 (IO0_4); also elsewhere on the board
FPGA_KEY_EN: U8.6 (IO0_5); also elsewhere on the board
FPGA_PWR_EN: U8.7 (IO0_6); also elsewhere on the board
FPGA_RST: U8.2 (IO0_1); also elsewhere on the board
FSPI_1A_CS: U100.F17 (GPIO_SD_B2_06); also elsewhere on the board
FSPI_1A_D0: U100.F15 (GPIO_SD_B2_08); also elsewhere on the board
FSPI_1A_D1: U100.H15 (GPIO_SD_B2_09); also elsewhere on the board
FSPI_1A_D2: U100.H14 (GPIO_SD_B2_10); also elsewhere on the board
FSPI_1A_D3: U100.F16 (GPIO_SD_B2_11); also elsewhere on the board
FSPI_1A_SCK: U100.G14 (GPIO_SD_B2_07); also elsewhere on the board
FSPI_2A_CS: U100.B16 (GPIO_SD_B1_00); also elsewhere on the board
FSPI_2A_D0: U100.C15 (GPIO_SD_B1_02); also elsewhere on the board
FSPI_2A_D1: U100.B17 (GPIO_SD_B1_03); also elsewhere on the board
FSPI_2A_D2: U100.B15 (GPIO_SD_B1_04); also elsewhere on the board
FSPI_2A_D3: U100.A16 (GPIO_SD_B1_05); also elsewhere on the board
FSPI_2A_SCK: U100.D15 (GPIO_SD_B1_01); also elsewhere on the board
GND: C100.2, C101.2, C102.2, C103.2, C104.2, C105.2, C106.2, C107.2, C108.2, C109.2, C110.2, C111.2, C112.2, C113.2, C114.2, C115.2, C116.2, C117.2, C118.2, C119.2, C120.2, C121.2, C122.2, C123.2, C124.2, C125.2, C126.2, C127.2, C128.2, C129.2, C130.2, C131.2, C132.2, C133.2, C134.2, C135.2, C136.2, C137.1, C138.1, C139.2, C140.2, C141.2, C142.2, C143.2, C144.2, C145.2, C146.2, J101.4, R101.2, U8.9 (VSS), U8.18 (A0), U8.23 (A1), U8.24 (A2), U100.A1 (VSS_1), U100.A17 (VSS_2), U100.B7 (VSS_3), U100.C8 (VSS_4), U100.C10 (VSS_5), U100.C12 (VSS_6), U100.C14 (VSS_7), U100.D4 (VSS_8), U100.F11 (VSS_9), U100.F12 (VSS_10), U100.F13 (VSS_11), U100.G3 (VSS_12), U100.G7 (VSS_13), U100.G8 (VSS_14), U100.G9 (VSS_15), U100.G10 (VSS_16), U100.G11 (VSS_17), U100.G15 (VSS_18), U100.H7 (VSS_19), U100.H11 (VSS_20), U100.J7 (VSS_21), U100.J11 (VSS_22), U100.K6 (DCDC_GND_1), U100.K7 (DCDC_GND_2), U100.K11 (VSS_23), U100.L3 (VSS_24), U100.L6 (DCDC_GND_3), U100.L10 (VSS_25), U100.L11 (VSS_26), U100.L15 (VSS_27), U100.P4 (VSS_28), U100.P14 (VSS_29), U100.R4 (VSS_34), U100.R7 (VSS_30), U100.T11 (TEST_MODE), U100.T12 (VSS_31), U100.U1 (VSS_32), U100.U6 (GPIO_LPSR_13), U100.U17 (VSS_33), Y100.2, Y100.4; also elsewhere on the board
I2C1_SCL: R102.2, U8.19 (SCL), U100.K16 (GPIO_AD_32); also elsewhere on the board
I2C1_SDA: R103.2, U8.20 (SDA), U100.H17 (GPIO_AD_33); also elsewhere on the board
I2C3_SCL: R104.2, U100.D11 (GPIO_DISP_B1_02); also elsewhere on the board
I2C3_SDA: R105.2, U100.E11 (GPIO_DISP_B1_03); also elsewhere on the board
I2C4_SCL: R107.2, U100.B6 (GPIO_DISP_B2_12); also elsewhere on the board
I2C4_SDA: R106.2, U100.A5 (GPIO_DISP_B2_13); also elsewhere on the board
IPSOUT: C100.1, R100.1, U100.L5 (DCDC_IN_Q), U100.M5 (DCDC_IN_1), U100.N5 (DCDC_IN_2); also elsewhere on the board
KEY_A: U8.17 (IO1_7); also elsewhere on the board
KEY_B: U8.10 (IO1_0); also elsewhere on the board
KEY_DOWN: U8.11 (IO1_1); also elsewhere on the board
KEY_LEFT: U8.12 (IO1_2); also elsewhere on the board
KEY_RIGHT: U8.13 (IO1_3); also elsewhere on the board
KEY_SELECT: U8.16 (IO1_6); also elsewhere on the board
KEY_START: U8.15 (IO1_5); also elsewhere on the board
KEY_UP: U8.14 (IO1_4); also elsewhere on the board
MIPI_CKN: U100.A9 (MIPI_DSI_CKN); also elsewhere on the board
MIPI_CKP: U100.B9 (MIPI_DSI_CKP); also elsewhere on the board
MIPI_D0N: U100.A8 (MIPI_DSI_DN0); also elsewhere on the board
MIPI_D0P: U100.B8 (MIPI_DSI_DP0); also elsewhere on the board
MIPI_D1N: U100.A10 (MIPI_DSI_DN1); also elsewhere on the board
MIPI_D1P: U100.B10 (MIPI_DSI_DP1); also elsewhere on the board
unnamed: C101.1, R100.2, U100.P3 (DCDC_PSWITCH)
unnamed: C102.1, R101.1, U100.N4 (DCDC_MODE)
unnamed: C110.1, U100.P12 (VDD_LPSR_ANA)
unnamed: C111.1, U100.P11 (VDD_LPSR_DIG)
unnamed: C113.1, C114.1, C115.1, L100.2, U100.G16 (ADC_VREFH), U100.K15 (VDDA_ADC_1P8), U100.M11 (VDDA_1P8_IN)
unnamed: C123.1, U100.U16 (XTALI), Y100.1
unnamed: C124.1, U100.T16 (XTALO), Y100.3
unnamed: C126.1, L102.1, U100.F9 (VDD_MIPI_1P8)
unnamed: C134.1, C136.1, U100.U11 (NVCC_SNVS), U100.U14 (VDD_SNVS_ANA)
unnamed: C135.1, U100.T14 (VDD_SNVS_DIG)
unnamed: C137.2, U100.T13 (RTC_XTALI), Y101.1
unnamed: C138.2, U100.U13 (RTC_XTALO), Y101.2
unnamed: C143.1, L103.1, U100.H12 (VDD_USB_1P8)
unnamed: C144.1, L104.1, U100.G12 (VDD_USB_3P3)
unnamed: L101.1, U100.T3 (DCDC_LP_1), U100.U3 (DCDC_LP_2)
unnamed: L101.2, U100.T4 (DCDC_LN_1), U100.U4 (DCDC_LN_2)
unnamed: TP100.1, U100.J2 (GPIO_EMC_B1_39)
unnamed: TP101.1, U100.N3 (GPIO_EMC_B2_18)
PMU_IRQ: U100.B14 (GPIO_DISP_B1_10); also elsewhere on the board
SAI1_MCLK: U100.D7 (GPIO_DISP_B2_03); also elsewhere on the board
SAI1_RX_BCLK: U100.C9 (GPIO_DISP_B2_05); also elsewhere on the board
SAI1_RX_DATA0: U100.C6 (GPIO_DISP_B2_06); also elsewhere on the board
SAI1_RX_SYNC: U100.C7 (GPIO_DISP_B2_04); also elsewhere on the board
SAI1_TX_BCLK: U100.B5 (GPIO_DISP_B2_08); also elsewhere on the board
SAI1_TX_DATA0: U100.D6 (GPIO_DISP_B2_07); also elsewhere on the board
SAI1_TX_SYNC: U100.D8 (GPIO_DISP_B2_09); also elsewhere on the board
SAI4_TX_BCLK: U100.N7 (GPIO_LPSR_04); also elsewhere on the board
SAI4_TX_DATA: U100.P6 (GPIO_LPSR_02); also elsewhere on the board
SAI4_TX_SYNC: U100.T7 (GPIO_LPSR_03); also elsewhere on the board
SDRAM_A0: U100.A3 (GPIO_EMC_B1_09); also elsewhere on the board
SDRAM_A1: U100.A2 (GPIO_EMC_B1_10); also elsewhere on the board
SDRAM_A2: U100.C2 (GPIO_EMC_B1_11); also elsewhere on the board
SDRAM_A3: U100.C5 (GPIO_EMC_B1_12); also elsewhere on the board
SDRAM_A4: U100.D5 (GPIO_EMC_B1_13); also elsewhere on the board
SDRAM_A5: U100.B1 (GPIO_EMC_B1_14); also elsewhere on the board
SDRAM_A6: U100.C1 (GPIO_EMC_B1_15); also elsewhere on the board
SDRAM_A7: U100.D3 (GPIO_EMC_B1_16); also elsewhere on the board
SDRAM_A8: U100.B3 (GPIO_EMC_B1_17); also elsewhere on the board
SDRAM_A9: U100.B4 (GPIO_EMC_B1_18); also elsewhere on the board
SDRAM_A10: U100.B2 (GPIO_EMC_B1_23); also elsewhere on the board
SDRAM_A11: U100.C4 (GPIO_EMC_B1_19); also elsewhere on the board
SDRAM_A12: U100.C3 (GPIO_EMC_B1_20); also elsewhere on the board
SDRAM_BA0: U100.G2 (GPIO_EMC_B1_21); also elsewhere on the board
SDRAM_BA1: U100.H2 (GPIO_EMC_B1_22); also elsewhere on the board
SDRAM_CAS: U100.J5 (GPIO_EMC_B1_24); also elsewhere on the board
SDRAM_CKE: U100.G5 (GPIO_EMC_B1_27); also elsewhere on the board
SDRAM_CLK: U100.J3 (GPIO_EMC_B1_26); also elsewhere on the board
SDRAM_CS0: U100.E6 (GPIO_EMC_B1_29); also elsewhere on the board
SDRAM_D0: U100.F3 (GPIO_EMC_B1_00); also elsewhere on the board
SDRAM_D1: U100.F2 (GPIO_EMC_B1_01); also elsewhere on the board
SDRAM_D2: U100.G4 (GPIO_EMC_B1_02); also elsewhere on the board
SDRAM_D3: U100.E4 (GPIO_EMC_B1_03); also elsewhere on the board
SDRAM_D4: U100.H5 (GPIO_EMC_B1_04); also elsewhere on the board
SDRAM_D5: U100.F4 (GPIO_EMC_B1_05); also elsewhere on the board
SDRAM_D6: U100.H4 (GPIO_EMC_B1_06); also elsewhere on the board
SDRAM_D7: U100.H3 (GPIO_EMC_B1_07); also elsewhere on the board
SDRAM_D8: U100.E3 (GPIO_EMC_B1_30); also elsewhere on the board
SDRAM_D9: U100.D2 (GPIO_EMC_B1_31); also elsewhere on the board
SDRAM_D10: U100.D1 (GPIO_EMC_B1_32); also elsewhere on the board
SDRAM_D11: U100.E2 (GPIO_EMC_B1_33); also elsewhere on the board
SDRAM_D12: U100.E1 (GPIO_EMC_B1_34); also elsewhere on the board
SDRAM_D13: U100.F1 (GPIO_EMC_B1_35); also elsewhere on the board
SDRAM_D14: U100.G1 (GPIO_EMC_B1_36); also elsewhere on the board
SDRAM_D15: U100.H1 (GPIO_EMC_B1_37); also elsewhere on the board
SDRAM_D16: U100.K2 (GPIO_EMC_B2_00); also elsewhere on the board
SDRAM_D17: U100.K4 (GPIO_EMC_B2_01); also elsewhere on the board
SDRAM_D18: U100.K3 (GPIO_EMC_B2_02); also elsewhere on the board
SDRAM_D19: U100.R1 (GPIO_EMC_B2_03); also elsewhere on the board
SDRAM_D20: U100.M1 (GPIO_EMC_B2_04); also elsewhere on the board
SDRAM_D21: U100.N1 (GPIO_EMC_B2_05); also elsewhere on the board
SDRAM_D22: U100.T1 (GPIO_EMC_B2_06); also elsewhere on the board
SDRAM_D23: U100.M3 (GPIO_EMC_B2_07); also elsewhere on the board
SDRAM_D24: U100.N2 (GPIO_EMC_B2_09); also elsewhere on the board
SDRAM_D25: U100.R2 (GPIO_EMC_B2_10); also elsewhere on the board
SDRAM_D26: U100.L4 (GPIO_EMC_B2_11); also elsewhere on the board
SDRAM_D27: U100.M2 (GPIO_EMC_B2_12); also elsewhere on the board
SDRAM_D28: U100.K5 (GPIO_EMC_B2_13); also elsewhere on the board
SDRAM_D29: U100.M4 (GPIO_EMC_B2_14); also elsewhere on the board
SDRAM_D30: U100.L2 (GPIO_EMC_B2_15); also elsewhere on the board
SDRAM_D31: U100.P2 (GPIO_EMC_B2_16); also elsewhere on the board
SDRAM_DM0: U100.F5 (GPIO_EMC_B1_08); also elsewhere on the board
SDRAM_DM1: U100.J1 (GPIO_EMC_B1_38); also elsewhere on the board
SDRAM_DM2: U100.P1 (GPIO_EMC_B2_08); also elsewhere on the board
SDRAM_DM3: U100.T2 (GPIO_EMC_B2_17); also elsewhere on the board
SDRAM_RAS: U100.J4 (GPIO_EMC_B1_25); also elsewhere on the board
SDRAM_WE: U100.E5 (GPIO_EMC_B1_28); also elsewhere on the board
SD_CLK: U100.F14 (GPIO_SD_B2_04); also elsewhere on the board
SD_CMD: U100.E14 (GPIO_SD_B2_05); also elsewhere on the board
SD_D0: U100.E15 (GPIO_SD_B2_03); also elsewhere on the board
SD_D1: U100.H13 (GPIO_SD_B2_02); also elsewhere on the board
SD_D2: U100.J14 (GPIO_SD_B2_01); also elsewhere on the board
SD_D3: U100.J15 (GPIO_SD_B2_00); also elsewhere on the board
UART2_RXD: U100.A6 (GPIO_DISP_B2_11); also elsewhere on the board
UART2_TXD: U100.D9 (GPIO_DISP_B2_10); also elsewhere on the board
USB_DM: U100.E16 (USB1_DN); also elsewhere on the board
USB_DP: U100.E17 (USB1_DP); also elsewhere on the board
VBUS: C145.1, U100.D17 (USB1_VBUS); also elsewhere on the board
WAKEUP: U100.T8 (WAKEUP); also elsewhere on the board

Notes on the sheet:
F7/F6/G6
J10

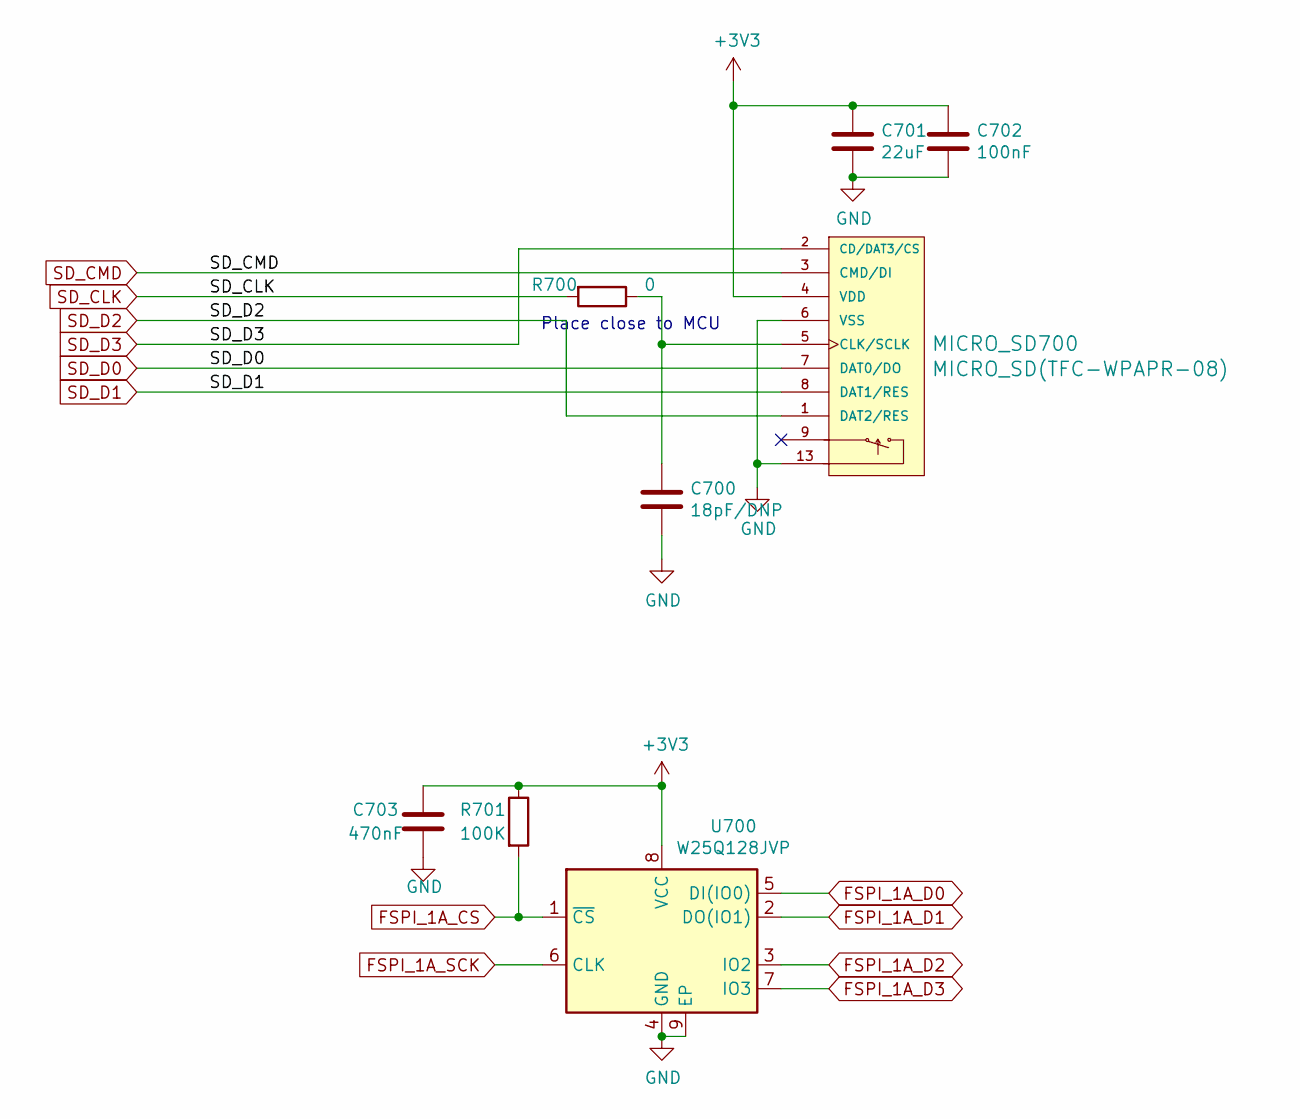
[picture p9: schematic microsd.kicad_sch, Fobu]

Parts:
C700: 18pF/DNP; C_0201_0603Metric
C701: 22uF; C_0603_1608Metric
C702: 100nF; C_0201_0603Metric
C703: 470nF; C_0201_0603Metric
MICRO_SD700: MICRO_SD(TFC-WPAPR-08); TFC-WPAPR-08
R700: 0; R_0402_1005Metric
R701: 100K; C_0402_1005Metric
U700: W25Q128JVP; WSON-8-1EP_6x5mm_P1.27mm_EP3.4x4.3mm

Connections:
+3V3: C701.1, C702.1, C703.2, MICRO_SD700.4 (VDD), R701.1, U700.8 (VCC); also elsewhere on the board
FSPI_1A_CS: R701.2, U700.1 (~CS); also elsewhere on the board
FSPI_1A_D0: U700.5 (DI(IO0)); also elsewhere on the board
FSPI_1A_D1: U700.2 (DO(IO1)); also elsewhere on the board
FSPI_1A_D2: U700.3 (IO2); also elsewhere on the board
FSPI_1A_D3: U700.7 (IO3); also elsewhere on the board
FSPI_1A_SCK: U700.6 (CLK); also elsewhere on the board
GND: C700.2, C701.2, C702.2, C703.1, MICRO_SD700.6 (VSS), MICRO_SD700.10, MICRO_SD700.11, MICRO_SD700.12, MICRO_SD700.13, U700.4 (GND), U700.9 (EP); also elsewhere on the board
unnamed: C700.1, MICRO_SD700.5 (CLK/SCLK), R700.1
SD_CLK: R700.2; also elsewhere on the board
SD_CMD: MICRO_SD700.3 (CMD/DI); also elsewhere on the board
SD_D0: MICRO_SD700.7 (DAT0/DO); also elsewhere on the board
SD_D1: MICRO_SD700.8 (DAT1/RES); also elsewhere on the board
SD_D2: MICRO_SD700.1 (DAT2/RES); also elsewhere on the board
SD_D3: MICRO_SD700.2 (CD/DAT3/CS); also elsewhere on the board

Notes on the sheet:
Place close to MCU

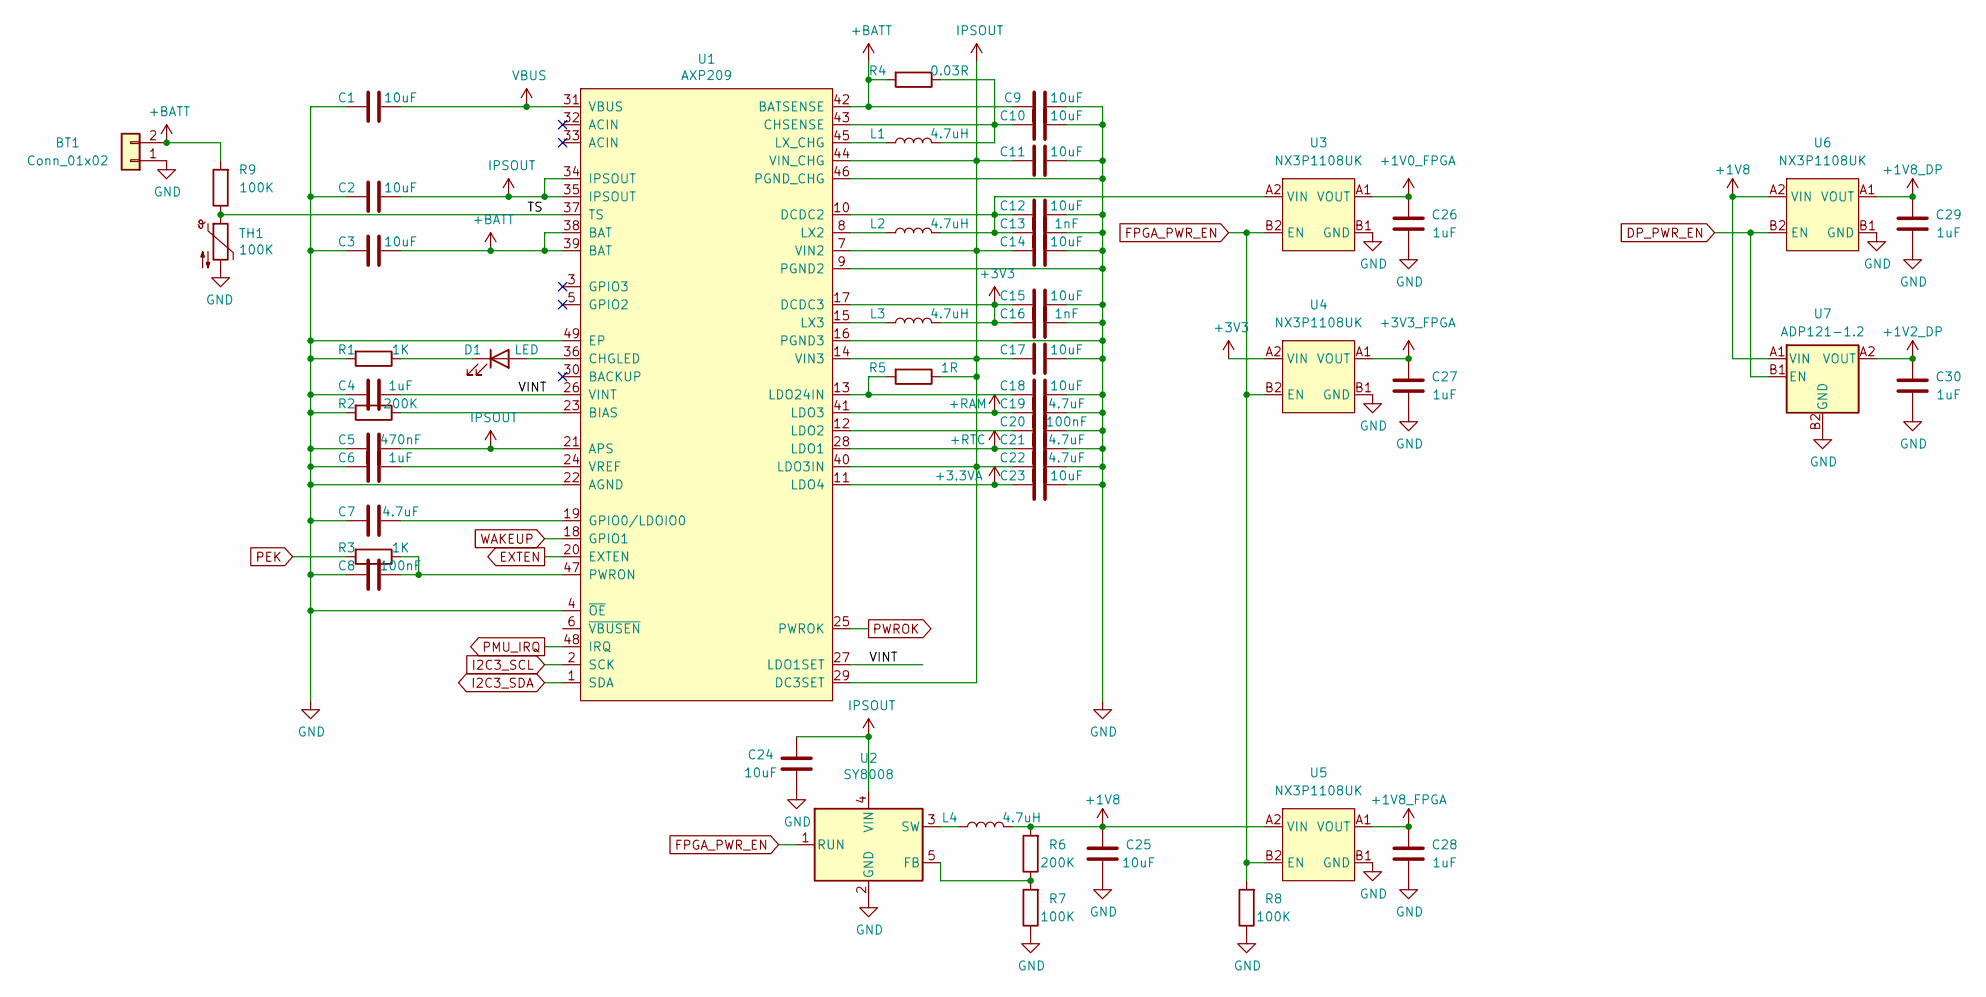
[picture p10: schematic power.kicad_sch, Fobu]

Parts:
BT1: Conn_01x02; Molex_PicoBlade_53261-0271_1x02-1MP_P1.25mm_Horizontal
C1, C2, C3, C9, C10, C11, C12, C14, C15, C17, C18, C23, C24, C25: 10uF; C_0402_1005Metric
C4, C6, C26, C27, C28, C29, C30: 1uF; C_0402_1005Metric
C5: 470nF; C_0201_0603Metric
C7, C19, C21, C22: 4.7uF; C_0402_1005Metric
C8, C20: 100nF; C_0201_0603Metric
C13, C16: 1nF; C_0402_1005Metric
D1: LED; D_0603_1608Metric
L1, L2, L3, L4: 4.7uH; L_1008_2520Metric
R1, R3: 1K; R_0402_1005Metric
R2, R6: 200K; R_0402_1005Metric
R4: 0.03R; R_0805_2012Metric
R5: 1R; R_0603_1608Metric
R7, R8, R9: 100K; R_0402_1005Metric
TH1: 100K; R_0603_1608Metric
U1: AXP209; QFN-48-1EP_6x6mm_P0.4mm_EP4.2x4.2mm_ThermalVias
U2: SY8008; TSOT-23-5
U3, U4, U5, U6: NX3P1108UK; WLCSP-4-X1-WLB0909-4_0.89x0.89mm_P0.5mm
U7: ADP121-1.2; CSP-4_2x2_0.8x0.8mm

Connections:
+1V0_FPGA: C26.2, U3.A1 (VOUT); also elsewhere on the board
+1V2_DP: C30.2, U7.A2 (VOUT); also elsewhere on the board
+1V8: C25.2, L4.2, R6.2, U5.A2 (VIN), U6.A2 (VIN), U7.A1 (VIN); also elsewhere on the board
+1V8_DP: C29.2, U6.A1 (VOUT); also elsewhere on the board
+3.3VA: C23.2, U1.11 (LDO4); also elsewhere on the board
+3V3: C15.2, C16.2, L3.2, U1.17 (DCDC3), U4.A2 (VIN); also elsewhere on the board
+3V3_FPGA: C27.2, U4.A1 (VOUT)
+BATT: BT1.2, C3.1, C9.2, R4.2, R9.2, U1.38 (BAT), U1.39 (BAT), U1.42 (BATSENSE)
+RAM: C19.2, U1.41 (LDO3); also elsewhere on the board
+RTC: C21.2, U1.28 (LDO1); also elsewhere on the board
/power/TS: R9.1, TH1.1, U1.37 (TS)
/power/VINT: C4.1, U1.26 (VINT), U1.27 (LDO1SET)
DP_PWR_EN: U6.B2 (EN), U7.B1 (EN); also elsewhere on the board
EXTEN: U1.20 (EXTEN)
FPGA_PWR_EN: R8.2, U2.1 (RUN), U3.B2 (EN), U4.B2 (EN), U5.B2 (EN); also elsewhere on the board
GND: BT1.1, C1.2, C2.2, C3.2, C4.2, C5.2, C6.2, C7.2, C8.2, C9.1, C10.1, C11.1, C12.1, C13.1, C14.1, C15.1, C16.1, C17.1, C18.1, C19.1, C20.1, C21.1, C22.1, C23.1, C24.1, C25.1, C26.1, C27.1, C28.1, C29.1, C30.1, R1.2, R2.2, R7.1, R8.1, TH1.2, U1.4 (~OE), U1.9 (PGND2), U1.16 (PGND3), U1.22 (AGND), U1.46 (PGND_CHG), U1.49 (EP), U2.2 (GND), U3.B1 (GND), U4.B1 (GND), U5.B1 (GND), U6.B1 (GND), U7.B2 (GND); also elsewhere on the board
I2C3_SCL: U1.2 (SCK); also elsewhere on the board
I2C3_SDA: U1.1 (SDA); also elsewhere on the board
IPSOUT: C2.1, C5.1, C11.2, C14.2, C17.2, C22.2, C24.2, R5.1, U1.7 (VIN2), U1.14 (VIN3), U1.21 (APS), U1.29 (DC3SET), U1.34 (IPSOUT), U1.35 (IPSOUT), U1.40 (LDO3IN), U1.44 (VIN_CHG), U2.4 (VIN); also elsewhere on the board
unnamed: C6.1, U1.24 (VREF)
unnamed: C7.1, U1.19 (GPIO0/LDOIO0)
unnamed: C8.1, R3.1, U1.47 (PWRON)
unnamed: C10.2, L1.2, R4.1, U1.43 (CHSENSE)
unnamed: C12.2, C13.2, L2.2, U1.10 (DCDC2), U3.A2 (VIN)
unnamed: C18.2, R5.2, U1.13 (LDO24IN)
unnamed: C20.2, U1.12 (LDO2)
unnamed: D1.1 (K), R1.1
unnamed: D1.2 (A), U1.36 (CHGLED)
unnamed: L1.1, U1.45 (LX_CHG)
unnamed: L2.1, U1.8 (LX2)
unnamed: L3.1, U1.15 (LX3)
unnamed: L4.1, U2.3 (SW)
unnamed: R2.1, U1.23 (BIAS)
unnamed: R6.1, R7.2, U2.5 (FB)
PEK: R3.2; also elsewhere on the board
PMU_IRQ: U1.48 (IRQ); also elsewhere on the board
PWROK: U1.25 (PWROK)
VBUS: C1.1, U1.31 (VBUS); also elsewhere on the board
WAKEUP: U1.18 (GPIO1); also elsewhere on the board
