zephray/Fobu/hardware/pcb/pcb.kicad_pcb

## KiCad design hardware/pcb/pcb.kicad_pcb (continued)

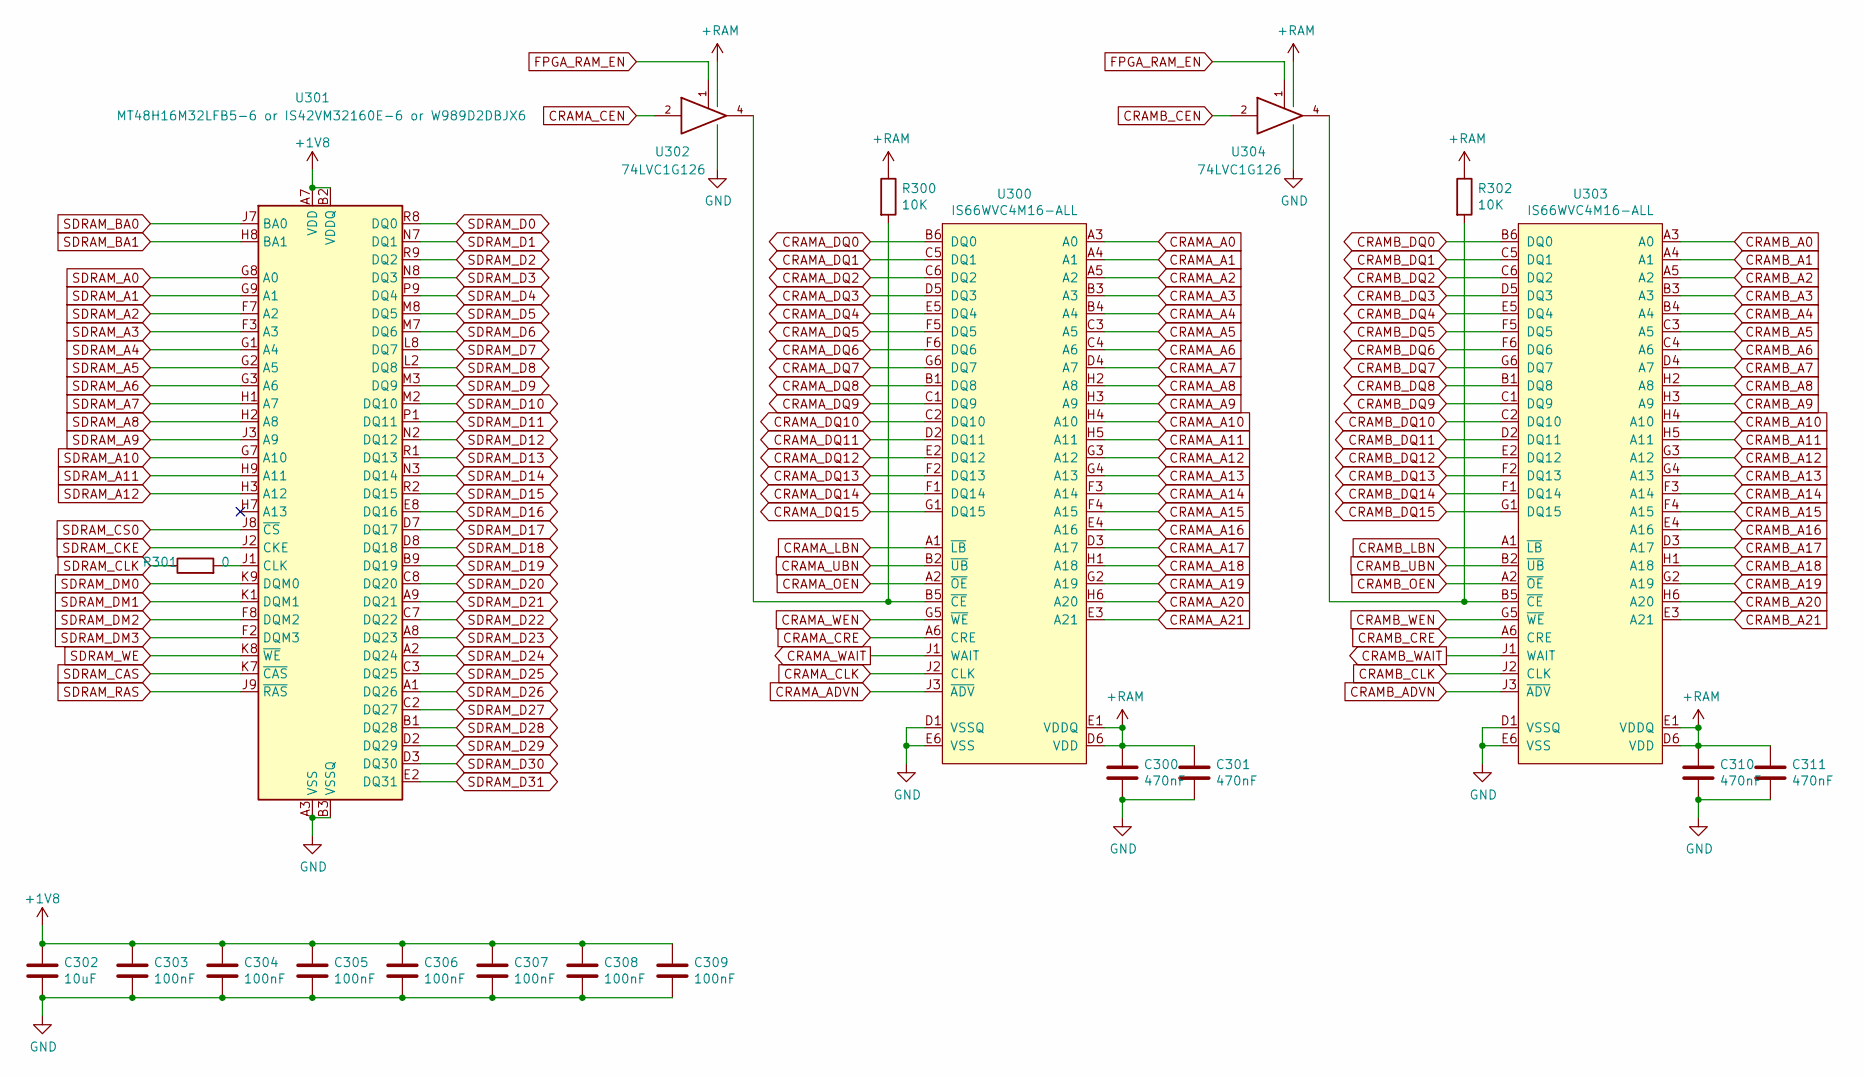
[picture p11: schematic ram.kicad_sch, Fobu]

Parts:
C300, C301, C310, C311: 470nF; C_0201_0603Metric
C302: 10uF; C_0402_1005Metric
C303, C304, C305, C306, C307, C308, C309: 100nF; C_0201_0603Metric
R300, R302: 10K; R_0402_1005Metric
R301: 0; R_0402_1005Metric
U300, U303: IS66WVC4M16-ALL; BGA-54_6x9_6.0x8.0mm
U301: MT48H16M32LFB5-6 or IS42VM32160E-6 or W989D2DBJX6; BGA-90_9x15_8.0x13.0mm
U302, U304: 74LVC1G126; SOT-353_SC-70-5

Connections:
+1V8: C302.1, C303.1, C304.1, C305.1, C306.1, C307.1, C308.1, C309.1, U301.A7 (VDD), U301.B2 (VDDQ), U301.B7 (VDDQ), U301.C9 (VDDQ), U301.D9 (VDDQ), U301.E1 (VDDQ), U301.F9 (VDD), U301.L1 (VDDQ), U301.L7 (VDD), U301.M9 (VDDQ), U301.N9 (VDDQ), U301.P2 (VDDQ), U301.P7 (VDDQ), U301.R7 (VDD); also elsewhere on the board
+RAM: C300.1, C301.1, C310.1, C311.1, R300.1, R302.1, U300.D6 (VDD), U300.E1 (VDDQ), U302.5 (VCC), U303.D6 (VDD), U303.E1 (VDDQ), U304.5 (VCC); also elsewhere on the board
CRAMA_A0: U300.A3 (A0); also elsewhere on the board
CRAMA_A1: U300.A4 (A1); also elsewhere on the board
CRAMA_A2: U300.A5 (A2); also elsewhere on the board
CRAMA_A3: U300.B3 (A3); also elsewhere on the board
CRAMA_A4: U300.B4 (A4); also elsewhere on the board
CRAMA_A5: U300.C3 (A5); also elsewhere on the board
CRAMA_A6: U300.C4 (A6); also elsewhere on the board
CRAMA_A7: U300.D4 (A7); also elsewhere on the board
CRAMA_A8: U300.H2 (A8); also elsewhere on the board
CRAMA_A9: U300.H3 (A9); also elsewhere on the board
CRAMA_A10: U300.H4 (A10); also elsewhere on the board
CRAMA_A11: U300.H5 (A11); also elsewhere on the board
CRAMA_A12: U300.G3 (A12); also elsewhere on the board
CRAMA_A13: U300.G4 (A13); also elsewhere on the board
CRAMA_A14: U300.F3 (A14); also elsewhere on the board
CRAMA_A15: U300.F4 (A15); also elsewhere on the board
CRAMA_A16: U300.E4 (A16); also elsewhere on the board
CRAMA_A17: U300.D3 (A17); also elsewhere on the board
CRAMA_A18: U300.H1 (A18); also elsewhere on the board
CRAMA_A19: U300.G2 (A19); also elsewhere on the board
CRAMA_A20: U300.H6 (A20); also elsewhere on the board
CRAMA_A21: U300.E3 (A21); also elsewhere on the board
CRAMA_ADVN: U300.J3 (~ADV); also elsewhere on the board
CRAMA_CEN: U302.2; also elsewhere on the board
CRAMA_CLK: U300.J2 (CLK); also elsewhere on the board
CRAMA_CRE: U300.A6 (CRE); also elsewhere on the board
CRAMA_DQ0: U300.B6 (DQ0); also elsewhere on the board
CRAMA_DQ1: U300.C5 (DQ1); also elsewhere on the board
CRAMA_DQ2: U300.C6 (DQ2); also elsewhere on the board
CRAMA_DQ3: U300.D5 (DQ3); also elsewhere on the board
CRAMA_DQ4: U300.E5 (DQ4); also elsewhere on the board
CRAMA_DQ5: U300.F5 (DQ5); also elsewhere on the board
CRAMA_DQ6: U300.F6 (DQ6); also elsewhere on the board
CRAMA_DQ7: U300.G6 (DQ7); also elsewhere on the board
CRAMA_DQ8: U300.B1 (DQ8); also elsewhere on the board
CRAMA_DQ9: U300.C1 (DQ9); also elsewhere on the board
CRAMA_DQ10: U300.C2 (DQ10); also elsewhere on the board
CRAMA_DQ11: U300.D2 (DQ11); also elsewhere on the board
CRAMA_DQ12: U300.E2 (DQ12); also elsewhere on the board
CRAMA_DQ13: U300.F2 (DQ13); also elsewhere on the board
CRAMA_DQ14: U300.F1 (DQ14); also elsewhere on the board
CRAMA_DQ15: U300.G1 (DQ15); also elsewhere on the board
CRAMA_LBN: U300.A1 (~LB); also elsewhere on the board
CRAMA_OEN: U300.A2 (~OE); also elsewhere on the board
CRAMA_UBN: U300.B2 (~UB); also elsewhere on the board
CRAMA_WAIT: U300.J1 (WAIT); also elsewhere on the board
CRAMA_WEN: U300.G5 (~WE); also elsewhere on the board
CRAMB_A0: U303.A3 (A0); also elsewhere on the board
CRAMB_A1: U303.A4 (A1); also elsewhere on the board
CRAMB_A2: U303.A5 (A2); also elsewhere on the board
CRAMB_A3: U303.B3 (A3); also elsewhere on the board
CRAMB_A4: U303.B4 (A4); also elsewhere on the board
CRAMB_A5: U303.C3 (A5); also elsewhere on the board
CRAMB_A6: U303.C4 (A6); also elsewhere on the board
CRAMB_A7: U303.D4 (A7); also elsewhere on the board
CRAMB_A8: U303.H2 (A8); also elsewhere on the board
CRAMB_A9: U303.H3 (A9); also elsewhere on the board
CRAMB_A10: U303.H4 (A10); also elsewhere on the board
CRAMB_A11: U303.H5 (A11); also elsewhere on the board
CRAMB_A12: U303.G3 (A12); also elsewhere on the board
CRAMB_A13: U303.G4 (A13); also elsewhere on the board
CRAMB_A14: U303.F3 (A14); also elsewhere on the board
CRAMB_A15: U303.F4 (A15); also elsewhere on the board
CRAMB_A16: U303.E4 (A16); also elsewhere on the board
CRAMB_A17: U303.D3 (A17); also elsewhere on the board
CRAMB_A18: U303.H1 (A18); also elsewhere on the board
CRAMB_A19: U303.G2 (A19); also elsewhere on the board
CRAMB_A20: U303.H6 (A20); also elsewhere on the board
CRAMB_A21: U303.E3 (A21); also elsewhere on the board
CRAMB_ADVN: U303.J3 (~ADV); also elsewhere on the board
CRAMB_CEN: U304.2; also elsewhere on the board
CRAMB_CLK: U303.J2 (CLK); also elsewhere on the board
CRAMB_CRE: U303.A6 (CRE); also elsewhere on the board
CRAMB_DQ0: U303.B6 (DQ0); also elsewhere on the board
CRAMB_DQ1: U303.C5 (DQ1); also elsewhere on the board
CRAMB_DQ2: U303.C6 (DQ2); also elsewhere on the board
CRAMB_DQ3: U303.D5 (DQ3); also elsewhere on the board
CRAMB_DQ4: U303.E5 (DQ4); also elsewhere on the board
CRAMB_DQ5: U303.F5 (DQ5); also elsewhere on the board
CRAMB_DQ6: U303.F6 (DQ6); also elsewhere on the board
CRAMB_DQ7: U303.G6 (DQ7); also elsewhere on the board
CRAMB_DQ8: U303.B1 (DQ8); also elsewhere on the board
CRAMB_DQ9: U303.C1 (DQ9); also elsewhere on the board
CRAMB_DQ10: U303.C2 (DQ10); also elsewhere on the board
CRAMB_DQ11: U303.D2 (DQ11); also elsewhere on the board
CRAMB_DQ12: U303.E2 (DQ12); also elsewhere on the board
CRAMB_DQ13: U303.F2 (DQ13); also elsewhere on the board
CRAMB_DQ14: U303.F1 (DQ14); also elsewhere on the board
CRAMB_DQ15: U303.G1 (DQ15); also elsewhere on the board
CRAMB_LBN: U303.A1 (~LB); also elsewhere on the board
CRAMB_OEN: U303.A2 (~OE); also elsewhere on the board
CRAMB_UBN: U303.B2 (~UB); also elsewhere on the board
CRAMB_WAIT: U303.J1 (WAIT); also elsewhere on the board
CRAMB_WEN: U303.G5 (~WE); also elsewhere on the board
FPGA_RAM_EN: U302.1, U304.1
GND: C300.2, C301.2, C302.2, C303.2, C304.2, C305.2, C306.2, C307.2, C308.2, C309.2, C310.2, C311.2, U300.D1 (VSSQ), U300.E6 (VSS), U301.A3 (VSS), U301.B3 (VSSQ), U301.B8 (VSSQ), U301.C1 (VSSQ), U301.D1 (VSSQ), U301.E9 (VSSQ), U301.F1 (VSS), U301.L3 (VSS), U301.L9 (VSSQ), U301.M1 (VSSQ), U301.N1 (VSSQ), U301.P3 (VSSQ), U301.P8 (VSSQ), U301.R3 (VSS), U302.3 (GND), U303.D1 (VSSQ), U303.E6 (VSS), U304.3 (GND); also elsewhere on the board
unnamed: R300.2, U300.B5 (~CE), U302.4
unnamed: R301.2, U301.J1 (CLK)
unnamed: R302.2, U303.B5 (~CE), U304.4
SDRAM_A0: U301.G8 (A0); also elsewhere on the board
SDRAM_A1: U301.G9 (A1); also elsewhere on the board
SDRAM_A2: U301.F7 (A2); also elsewhere on the board
SDRAM_A3: U301.F3 (A3); also elsewhere on the board
SDRAM_A4: U301.G1 (A4); also elsewhere on the board
SDRAM_A5: U301.G2 (A5); also elsewhere on the board
SDRAM_A6: U301.G3 (A6); also elsewhere on the board
SDRAM_A7: U301.H1 (A7); also elsewhere on the board
SDRAM_A8: U301.H2 (A8); also elsewhere on the board
SDRAM_A9: U301.J3 (A9); also elsewhere on the board
SDRAM_A10: U301.G7 (A10); also elsewhere on the board
SDRAM_A11: U301.H9 (A11); also elsewhere on the board
SDRAM_A12: U301.H3 (A12); also elsewhere on the board
SDRAM_BA0: U301.J7 (BA0); also elsewhere on the board
SDRAM_BA1: U301.H8 (BA1); also elsewhere on the board
SDRAM_CAS: U301.K7 (~CAS); also elsewhere on the board
SDRAM_CKE: U301.J2 (CKE); also elsewhere on the board
SDRAM_CLK: R301.1; also elsewhere on the board
SDRAM_CS0: U301.J8 (~CS); also elsewhere on the board
SDRAM_D0: U301.R8 (DQ0); also elsewhere on the board
SDRAM_D1: U301.N7 (DQ1); also elsewhere on the board
SDRAM_D2: U301.R9 (DQ2); also elsewhere on the board
SDRAM_D3: U301.N8 (DQ3); also elsewhere on the board
SDRAM_D4: U301.P9 (DQ4); also elsewhere on the board
SDRAM_D5: U301.M8 (DQ5); also elsewhere on the board
SDRAM_D6: U301.M7 (DQ6); also elsewhere on the board
SDRAM_D7: U301.L8 (DQ7); also elsewhere on the board
SDRAM_D8: U301.L2 (DQ8); also elsewhere on the board
SDRAM_D9: U301.M3 (DQ9); also elsewhere on the board
SDRAM_D10: U301.M2 (DQ10); also elsewhere on the board
SDRAM_D11: U301.P1 (DQ11); also elsewhere on the board
SDRAM_D12: U301.N2 (DQ12); also elsewhere on the board
SDRAM_D13: U301.R1 (DQ13); also elsewhere on the board
SDRAM_D14: U301.N3 (DQ14); also elsewhere on the board
SDRAM_D15: U301.R2 (DQ15); also elsewhere on the board
SDRAM_D16: U301.E8 (DQ16); also elsewhere on the board
SDRAM_D17: U301.D7 (DQ17); also elsewhere on the board
SDRAM_D18: U301.D8 (DQ18); also elsewhere on the board
SDRAM_D19: U301.B9 (DQ19); also elsewhere on the board
SDRAM_D20: U301.C8 (DQ20); also elsewhere on the board
SDRAM_D21: U301.A9 (DQ21); also elsewhere on the board
SDRAM_D22: U301.C7 (DQ22); also elsewhere on the board
SDRAM_D23: U301.A8 (DQ23); also elsewhere on the board
SDRAM_D24: U301.A2 (DQ24); also elsewhere on the board
SDRAM_D25: U301.C3 (DQ25); also elsewhere on the board
SDRAM_D26: U301.A1 (DQ26); also elsewhere on the board
SDRAM_D27: U301.C2 (DQ27); also elsewhere on the board
SDRAM_D28: U301.B1 (DQ28); also elsewhere on the board
SDRAM_D29: U301.D2 (DQ29); also elsewhere on the board
SDRAM_D30: U301.D3 (DQ30); also elsewhere on the board
SDRAM_D31: U301.E2 (DQ31); also elsewhere on the board
SDRAM_DM0: U301.K9 (DQM0); also elsewhere on the board
SDRAM_DM1: U301.K1 (DQM1); also elsewhere on the board
SDRAM_DM2: U301.F8 (DQM2); also elsewhere on the board
SDRAM_DM3: U301.F2 (DQM3); also elsewhere on the board
SDRAM_RAS: U301.J9 (~RAS); also elsewhere on the board
SDRAM_WE: U301.K8 (~WE); also elsewhere on the board

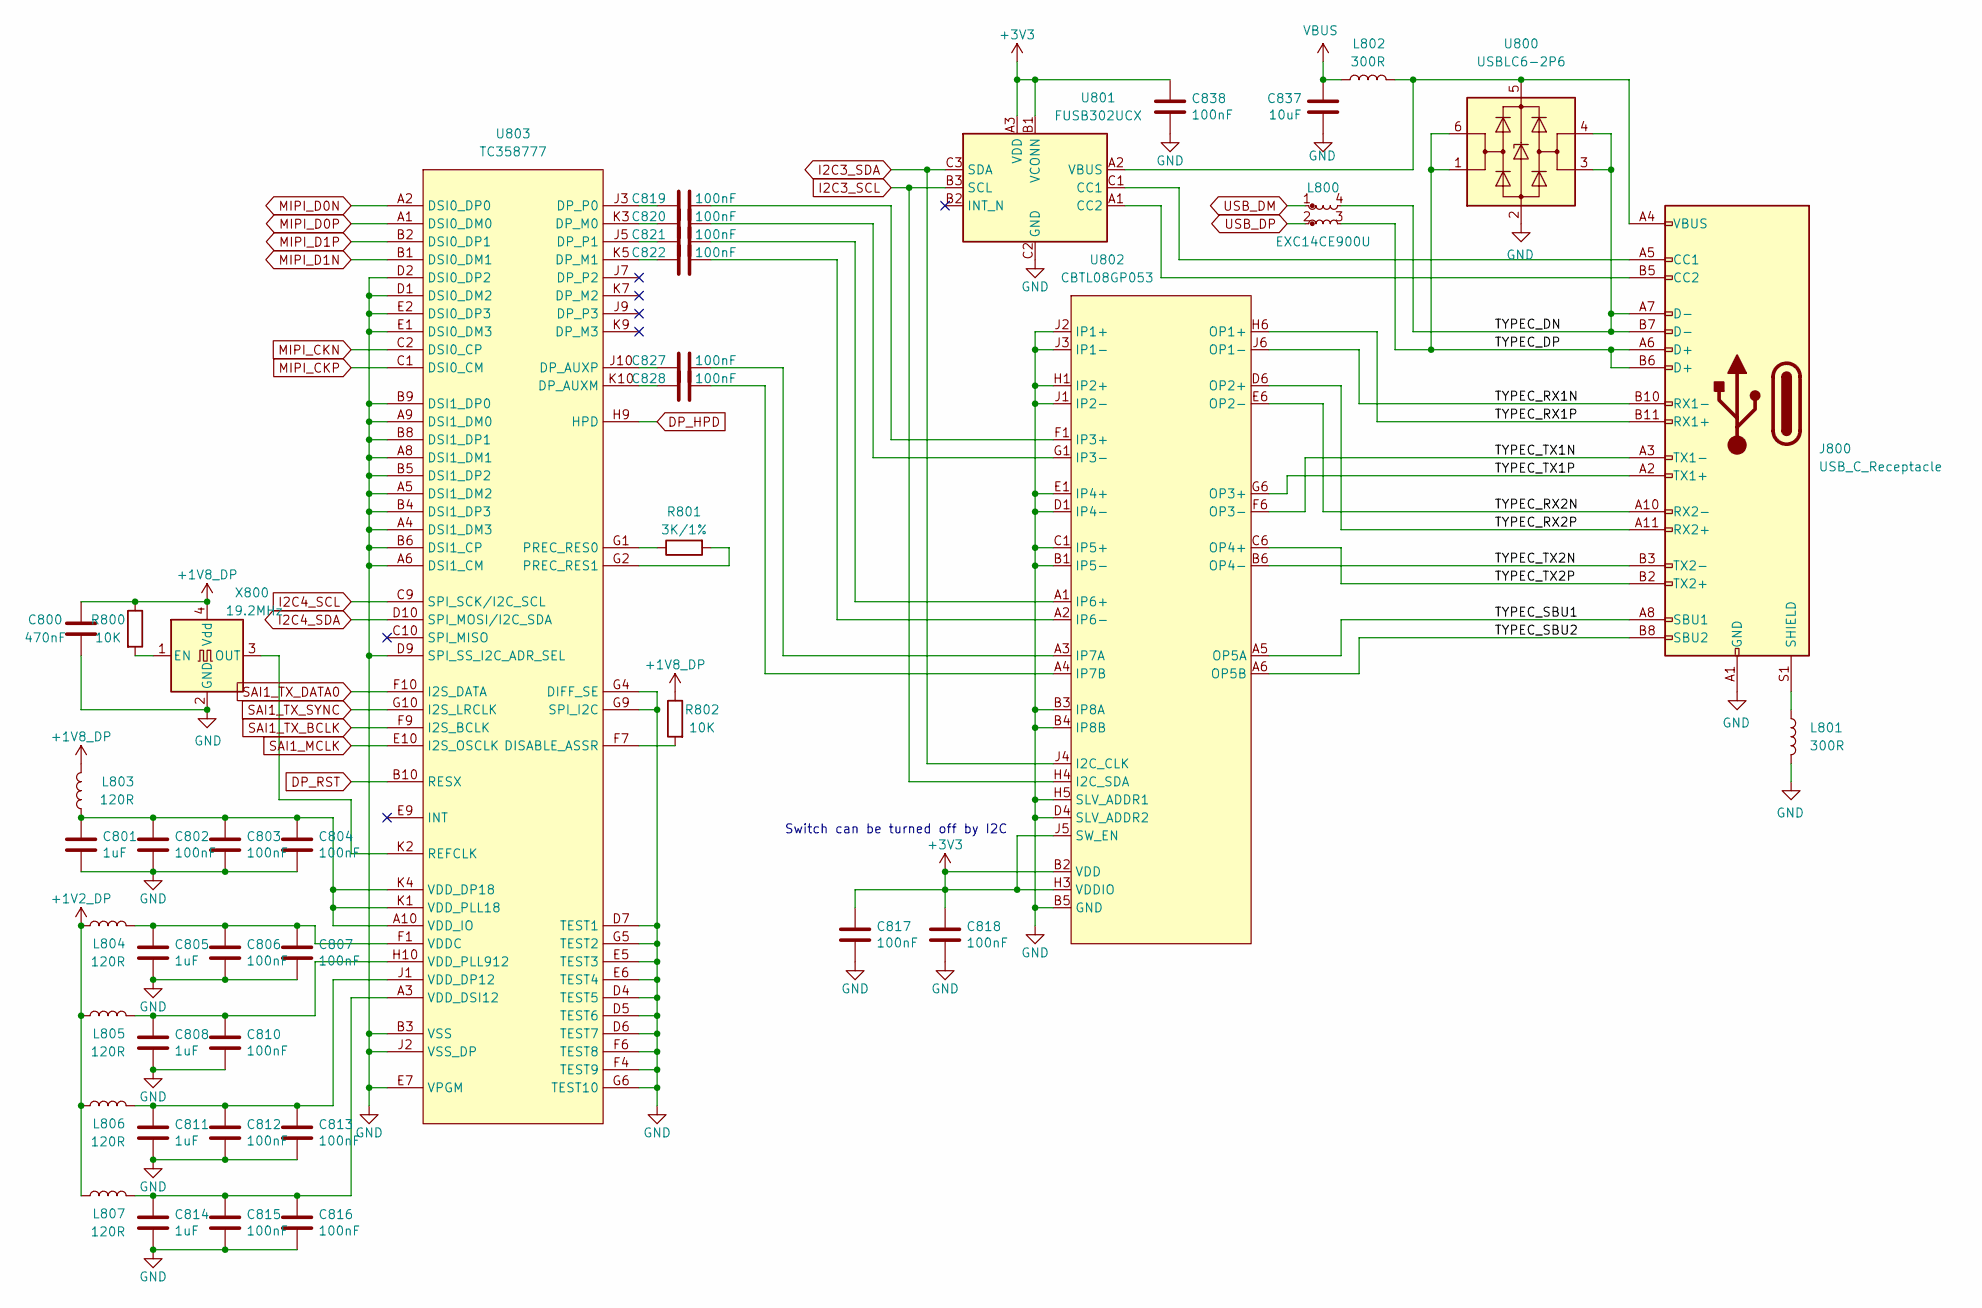
[picture p12: schematic usb.kicad_sch, Fobu]

Parts:
C800: 470nF; C_0201_0603Metric
C801, C805, C808, C811, C814: 1uF; C_0402_1005Metric
C802, C803, C804, C806, C807, C810, C812, C813, C815, C816, C817, C818, C819, C820, C821, C822, C827, C828, C838: 100nF; C_0201_0603Metric
C837: 10uF; C_0402_1005Metric
J800: USB_C_Receptacle; USB_C_Receptacle_Amphenol_12401548E4-2A
L800: EXC14CE900U; L_CommonModeChoke_Panasonic_EXC14CE
L801, L802: 300R; L_0603_1608Metric
L803, L804, L805, L806, L807: 120R; L_0402_1005Metric
R800, R802: 10K; C_0402_1005Metric
R801: 3K/1%; C_0402_1005Metric
U800: USBLC6-2P6; SOT-666
U801: FUSB302UCX; WLP-9_1.448x1.468mm_Layout3x3_P0.4mm_Ball0.27mm_Pad0.25mm
U802: CBTL08GP053; BGA-40_6x9_3.5x5.0mm
U803: TC358777; BGA-80_10x10_7.0x7.0mm
X800: 19.2MHz; Oscillator_SMD_Abracon_ASE-4Pin_3.2x2.5mm

Connections:
+1V2_DP: L804.1, L805.1, L806.1, L807.1; also elsewhere on the board
+1V8_DP: C800.2, L803.2, R800.1, R802.1, X800.4 (Vdd); also elsewhere on the board
+3V3: C817.1, C818.1, C838.1, U801.A3 (VDD), U801.B1 (VCONN), U802.B2 (VDD), U802.E3 (VDD), U802.E4 (VDDIO), U802.H3 (VDDIO), U802.J5 (SW_EN); also elsewhere on the board
/usb/TYPEC_DN: J800.A7 (D-), J800.B7 (D-), L800.4, U800.3 (I/O2), U800.4 (I/O2)
/usb/TYPEC_DP: J800.A6 (D+), J800.B6 (D+), L800.3, U800.1 (I/O1), U800.6 (I/O1)
/usb/TYPEC_RX1N: J800.B10 (RX1-), U802.J6 (OP1-)
/usb/TYPEC_RX1P: J800.B11 (RX1+), U802.H6 (OP1+)
/usb/TYPEC_RX2N: J800.A10 (RX2-), U802.E6 (OP2-)
/usb/TYPEC_RX2P: J800.A11 (RX2+), U802.D6 (OP2+)
/usb/TYPEC_SBU1: J800.A8 (SBU1), U802.A5 (OP5A)
/usb/TYPEC_SBU2: J800.B8 (SBU2), U802.A6 (OP5B)
/usb/TYPEC_TX1N: J800.A3 (TX1-), U802.F6 (OP3-)
/usb/TYPEC_TX1P: J800.A2 (TX1+), U802.G6 (OP3+)
/usb/TYPEC_TX2N: J800.B3 (TX2-), U802.B6 (OP4-)
/usb/TYPEC_TX2P: J800.B2 (TX2+), U802.C6 (OP4+)
DP_HPD: U803.H9 (HPD)
DP_RST: U803.B10 (RESX)
GND: C800.1, C801.2, C802.2, C803.2, C804.2, C805.2, C806.2, C807.2, C808.2, C810.2, C811.2, C812.2, C813.2, C814.2, C815.2, C816.2, C817.2, C818.2, C837.2, C838.2, J800.A1 (GND), J800.A12 (GND), J800.B1 (GND), J800.B12 (GND), L801.2, U800.2 (GND), U801.C2 (GND), U802.B1 (IP5-), U802.B3 (IP8A), U802.B4 (IP8B), U802.B5 (GND), U802.C1 (IP5+), U802.D1 (IP4-), U802.D3 (GND), U802.D4 (SLV_ADDR2), U802.E1 (IP4+), U802.F3 (GND), U802.F4 (GND), U802.H1 (IP2+), U802.H2 (GND), U802.H5 (SLV_ADDR1), U802.J1 (IP2-), U802.J2 (IP1+), U802.J3 (IP1-), U803.A4 (DSI1_DM3), U803.A5 (DSI1_DM2), U803.A6 (DSI1_CM), U803.A8 (DSI1_DM1), U803.A9 (DSI1_DM0), U803.B3 (VSS), U803.B4 (DSI1_DP3), U803.B5 (DSI1_DP2), U803.B6 (DSI1_CP), U803.B7 (VSS), U803.B8 (DSI1_DP1), U803.B9 (DSI1_DP0), U803.D1 (DSI0_DM2), U803.D2 (DSI0_DP2), U803.D4 (TEST5), U803.D5 (TEST6), U803.D6 (TEST7), U803.D7 (TEST1), U803.D9 (SPI_SS_I2C_ADR_SEL), U803.E1 (DSI0_DM3), U803.E2 (DSI0_DP3), U803.E4 (VSS), U803.E5 (TEST3), U803.E6 (TEST4), U803.E7 (VPGM), U803.F2 (VSS), U803.F4 (TEST9), U803.F5 (VSS), U803.F6 (TEST8), U803.G4 (DIFF_SE), U803.G5 (TEST2), U803.G6 (TEST10), U803.G7 (VSS), U803.G9 (SPI_I2C), U803.H2 (VSS), U803.J2 (VSS_DP), U803.J4 (VSS_DP), U803.J6 (VSS_DP), U803.J8 (VSS_DP), X800.2 (GND); also elsewhere on the board
I2C3_SCL: U801.B3 (SCL), U802.H4 (I2C_SDA); also elsewhere on the board
I2C3_SDA: U801.C3 (SDA), U802.J4 (I2C_CLK); also elsewhere on the board
I2C4_SCL: U803.C9 (SPI_SCK/I2C_SCL); also elsewhere on the board
I2C4_SDA: U803.D10 (SPI_MOSI/I2C_SDA); also elsewhere on the board
MIPI_CKN: U803.C2 (DSI0_CP); also elsewhere on the board
MIPI_CKP: U803.C1 (DSI0_CM); also elsewhere on the board
MIPI_D0N: U803.A2 (DSI0_DP0); also elsewhere on the board
MIPI_D0P: U803.A1 (DSI0_DM0); also elsewhere on the board
MIPI_D1N: U803.B1 (DSI0_DM1); also elsewhere on the board
MIPI_D1P: U803.B2 (DSI0_DP1); also elsewhere on the board
unnamed: C801.1, C802.1, C803.1, C804.1, L803.1, U803.A10 (VDD_IO), U803.K1 (VDD_PLL18), U803.K4 (VDD_DP18), U803.K8 (VDD_DP18)
unnamed: C805.1, C806.1, C807.1, L804.2, U803.F1 (VDDC), U803.H1 (VDDC)
unnamed: C808.1, C810.1, L805.2, U803.H10 (VDD_PLL912)
unnamed: C811.1, C812.1, C813.1, L806.2, U803.J1 (VDD_DP12), U803.K6 (VDD_DP12)
unnamed: C814.1, C815.1, C816.1, L807.2, U803.A3 (VDD_DSI12), U803.A7 (VDD_DSI12)
unnamed: C819.1, U803.J3 (DP_P0)
unnamed: C819.2, U802.F1 (IP3+)
unnamed: C820.1, U803.K3 (DP_M0)
unnamed: C820.2, U802.G1 (IP3-)
unnamed: C821.1, U803.J5 (DP_P1)
unnamed: C821.2, U802.A1 (IP6+)
unnamed: C822.1, U803.K5 (DP_M1)
unnamed: C822.2, U802.A2 (IP6-)
unnamed: C827.1, U803.J10 (DP_AUXP)
unnamed: C827.2, U802.A3 (IP7A)
unnamed: C828.1, U803.K10 (DP_AUXM)
unnamed: C828.2, U802.A4 (IP7B)
unnamed: J800.A4 (VBUS), J800.A9 (VBUS), J800.B4 (VBUS), J800.B9 (VBUS), L802.2, U800.5 (VBUS), U801.A2 (VBUS)
unnamed: J800.A5 (CC1), U801.C1 (CC1)
unnamed: J800.B5 (CC2), U801.A1 (CC2)
unnamed: J800.S1 (SHIELD), L801.1
unnamed: R800.2, X800.1 (EN)
unnamed: R801.1, U803.G1 (PREC_RES0)
unnamed: R801.2, U803.G2 (PREC_RES1)
unnamed: R802.2, U803.F7 (DISABLE_ASSR)
unnamed: U803.K2 (REFCLK), X800.3 (OUT)
SAI1_MCLK: U803.E10 (I2S_OSCLK); also elsewhere on the board
SAI1_TX_BCLK: U803.F9 (I2S_BCLK); also elsewhere on the board
SAI1_TX_DATA0: U803.F10 (I2S_DATA); also elsewhere on the board
SAI1_TX_SYNC: U803.G10 (I2S_LRCLK); also elsewhere on the board
USB_DM: L800.1; also elsewhere on the board
USB_DP: L800.2; also elsewhere on the board
VBUS: C837.1, L802.1; also elsewhere on the board

Notes on the sheet:
Switch can be turned off by I2C

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
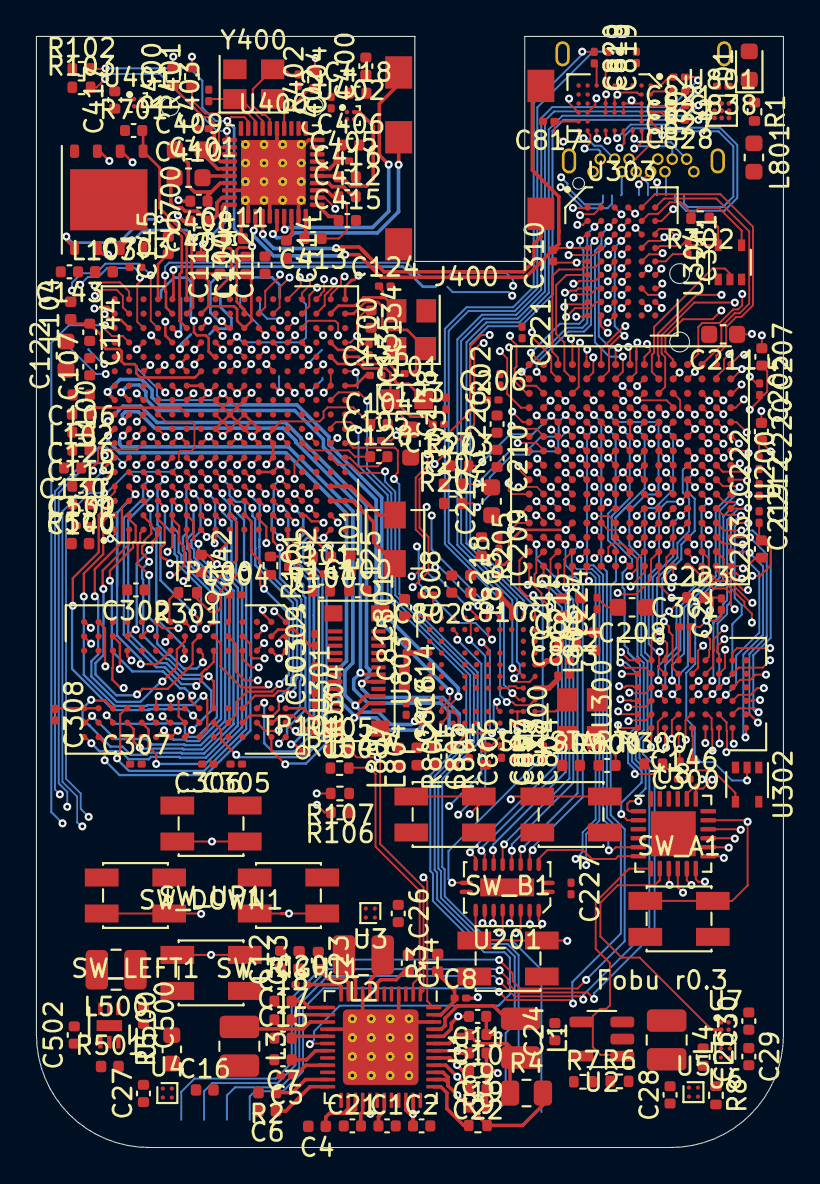
[picture p13: board pcb.kicad_pcb from above]

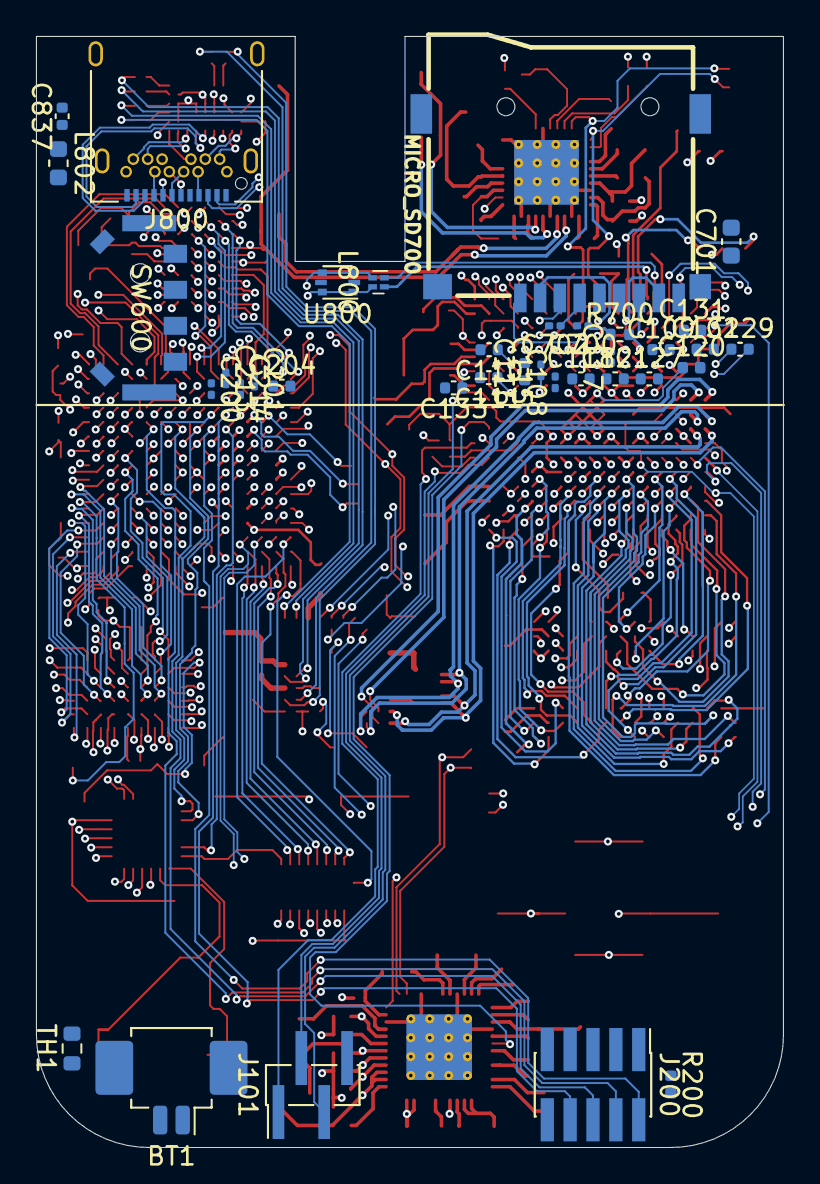
[picture p14: board pcb.kicad_pcb from below]

Board: 6 copper layers, 41.5 x 61.7 mm, 273 parts (36 on the bottom side), 369 nets.
