zephray/Fobu/(commit log)

2021-02-18 - Initial wip hardware design
    [audio.sch, fpga.sch, keypad.sch, lcd.sch, microsd.sch, pcb.kicad_pcb, pcb.sch, power.sch]
2021-02-27 - Migrate to KiCAD 5.99 nightly, pcb initial layout
    [audio.kicad_sch, audio.sch, fpga.kicad_sch, fpga.sch, keypad.kicad_sch, keypad.sch, lcd.kicad_sch, lcd.sch]
2021-03-08 - Working on pcb layout
    [audio.kicad_sch, fpga.kicad_sch, mcu.kicad_sch, pcb.kicad_pcb, pcb.kicad_sch, power.kicad_sch, ram.kicad_sch, usb.kicad_sch]
2021-03-13 - PCB r0.3 routed, need to finalize
    [audio.kicad_sch, fpga.kicad_sch, keypad.kicad_sch, lcd.kicad_sch, mcu.kicad_sch, microsd.kicad_sch, pcb.kicad_sch, power.kicad_sch]
2021-03-17 - PCB layout finished for r0p3
    [fpga.kicad_sch, mcu.kicad_sch, microsd.kicad_sch, pcb.kicad_sch, power.kicad_sch, usb.kicad_sch]
2021-04-22 - PCB: prepare for r0p4
    [audio.kicad_sch, lcd.kicad_sch, mcu.kicad_sch, pcb.kicad_sch, power.kicad_sch, usb.kicad_sch]
2022-03-19 - pcb: r0p4, update to KiCAD 6.0
    [audio.kicad_sch, fpga.kicad_sch, keypad.kicad_sch, lcd.kicad_sch, mcu.kicad_sch, microsd.kicad_sch, pcb.kicad_sch, power.kicad_sch]
